Ulimanopano/Robot-6GDL/Robot_6GDL_V11/04_Documentacion/Cinematica_directa_V11_apuntes.pdf

Título: | Cinemática directa — | Robot | 6GDL V9
Tabla DH (Craig / | modificada) y robot

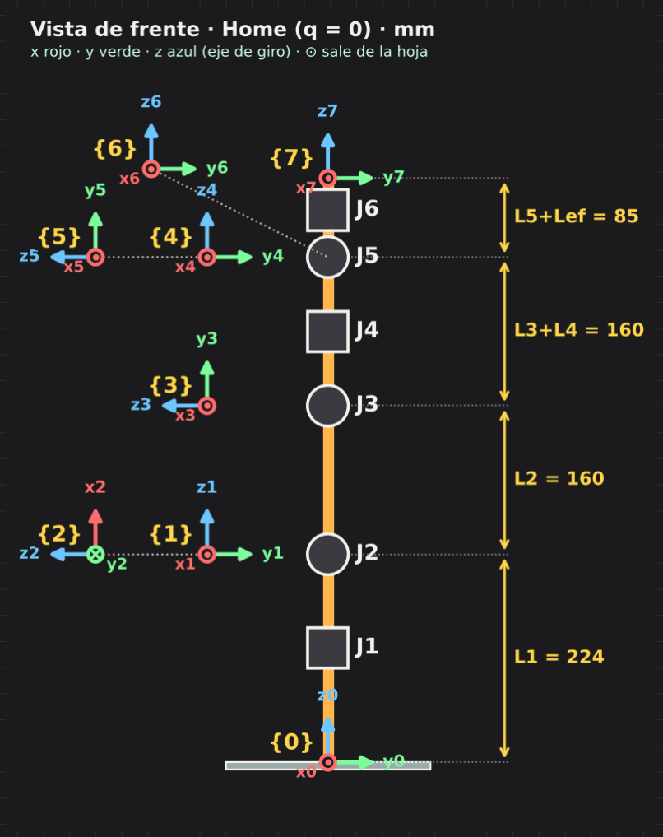
[picture p1: figure]

xi−1 ∶ | zi−1→ zi

zi

∶ | xi−1→ xi
i | αi−1 | ai−1 | di

θi

1 | 0 | 0 | L1

θ1
2 | π/2 | 0 | 0 | θ2 | + π/2
3 | 0 | L2 | 0 | θ3 | − π/2
4 | −π/2 | 0 | L3 | + L4

θ4
5 | π/2 | 0 | 0 | θ5
6 | −π/2 | 0 | 0 | θ6
7 | 0 | 0 | L5 | + Lef | 0

q = [θ1

, θ2

, θ3

, θ4

, θ5

, θ6

]

T

Notación
ci = cos θi
, | si = sin θi
c23 | = cos(θ2 | + θ3

)
s23 | = sin(θ2 | + θ3

)
Lw = L3 + L4
(hasta la muñeca)

Medidas (mm)
L1 | = 224, | L2 | = 160
Lw | = 160, | L5 | + Lef = 85

Muñeca esférica
Los ejes de J4, J5 y J6 se cruzan en el punto
W, por | eso | 4
5T y

5
6T no tienen traslación.

Matriz | de | una fila

i−1
iT = Rx

(αi−1) Dx

(ai−1) Rz

(θi

) Dz

(di

) =

⎡
⎢
⎢
⎣
cθi | −sθi | 0 | ai−1
sθi
cαi−1 | cθi
cαi−1 | −sαi−1 | −sαi−1 di
sθi
sαi−1 | cθi
sαi−1 | cαi−1 | cαi−1 di
0 | 0 | 0 | 1

⎤
⎥
⎥
⎦
Ojo | con los offsets | (identidades)
Fila | 2: | cos(θ2 +

π
2

) = −s2

, sin(θ2 +

π
2

) = c2
Fila | 3: | cos(θ3 −

π
2

) = s3

| , | sin(θ3 −

π
2

) = −c3
Con | α = ±π/2: cos α = 0 y | sin α = ±1, | por | eso aparecen | los 0 | y | ±1 en las columnas 2 y 3.
1. Matrices | de | cada | fila

0
1T =

⎡
⎢
⎢
⎣
c1 | −s1 0 | 0
s1
c1 | 0 | 0
0 | 0 | 1 | L1
0 | 0 | 0 | 1

⎤
⎥
⎥
⎦

1
2T =

⎡
⎢
⎢
⎣
−s2 | −c2 | 0 | 0
0 | 0 | −1 0
c2 | −s2 | 0 | 0
0 | 0 | 0 | 1

⎤
⎥
⎥
⎦

2
3T =

⎡
⎢
⎢
⎣

s3

c3 0 L2
−c3
s3 0 | 0
0 | 0 | 1 | 0
0 | 0 | 0 | 1

⎤
⎥
⎥
⎦

3
4T =

⎡
⎢
⎢
⎣
c4 | −s4 0 | 0
0 | 0 | 1 | Lw
−s4 | −c4 0 | 0
0 | 0 | 0 | 1

⎤
⎥
⎥
⎦

4
5T =

⎡
⎢
⎢
⎣
c5 | −s5 | 0 | 0
0 | 0 | −1 0
s5
c5 | 0 | 0
0 | 0 | 0 | 1

⎤
⎥
⎥
⎦

5
6T =

⎡
⎢
⎢
⎣
c6 | −s6 | 0 | 0
0 | 0 | 1 | 0
−s6 | −c6 | 0 | 0
0 | 0 | 0 | 1

⎤
⎥
⎥
⎦

6
7T =

⎡
⎢
⎢
⎣
1 | 0 | 0 | | 0
0 | 1 | 0 | | 0
0 | 0 | 1 | (L5 | + Lef )
0 | 0 | 0 | | 1

⎤
⎥
⎥
⎦

2. Multiplicación | paso a paso
Se | va multiplicando | por la derecha: | cada nueva fila | se | pega a lo que ya | se | tenía.

0

2T = 0
1T

1
2T =

⎡
⎢
⎢
⎣
c1 | −s1 0 | 0
s1
c1 | 0 | 0
0 | 0 | 1 | L1
0 | 0 | 0 | 1

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
−s2 | −c2 | 0 | 0
0 | 0 | −1 | 0
c2 | −s2 | 0 | 0
0 | 0 | 0 | 1

⎤
⎥
⎥
⎦

0
2T =

⎡
⎢
⎢
⎣

−c1

s2 | −c1 c2 | s1 | 0
−s1
s2 | −c2
| s1 | −c1 | 0
c2 | −s2 | 0 | L1
0 | 0 | 0 | 1

⎤
⎥
⎥
⎦

0

3T = 0
2T

2
3T =

⎡
⎢
⎢
⎣

−c1

s2 −c1

c2

s1 0
−s1
s2 | −c2
s1 | −c1 | 0
c2 | −s2 | 0 | L1
0 | 0 | 0 | 1

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
c3 0 L2
−c3
s3 0 | 0
0 | 0 | 1 | 0
0 | 0 | 0 | 1

⎤
⎥
⎥
⎦

0
3T =

⎡
⎢
⎢
⎣

c1

c23 | −c1
s23 | s1 | −L2
| | | | c1 s2
c23s1 | −s1
s23 | −c1 | −L2
| | | | s1 s2
s23 | c23 | 0 | L1 | + L2

c2
0 | 0 | 0 | | 1

⎤
⎥
⎥
⎦
Aquí aparece | c23: | c2
c3 − s2
s3 = cos(θ2 | + θ3
) y | s2 c3 + c2
s3 = sin(θ2 | + θ3
) | (J2 y J3 son paralelos).

0

4T = 0
3T

3
4T =

⎡
⎢
⎢
⎣

c1

c23 | −c1
s23 | s1 | −L2

c1

s2
c23s1 | −s1
s23 | −c1 | −L2

s1

s2
s23 | c23 | 0 | L1 + L2

c2
0 | 0 | 0 | 1

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
c4 | −s4 | 0 | 0
0 | 0 | 1 | Lw
−s4 | −c4 | 0 | 0
0 | 0 | 0 | 1

⎤
⎥
⎥
⎦

0
4T =

⎡
⎢
⎢
⎣

c1

c23c4 − s1

s4 | −c1
c23s4 | − c4
s1 | −c1
s23 | −L2

c1

s2 − Lwc1

s23
c1

s4 + c23c4

s1

c1

c4 − c23s1

s4 | −s1
s23 | −L2

s1

s2 − Lws1

s23
c4
s23 | −s23s4
c23 | L1 | + L2
| | | c2 + Lwc23
0 | 0 | 0 | 1

⎤
⎥
⎥
⎦

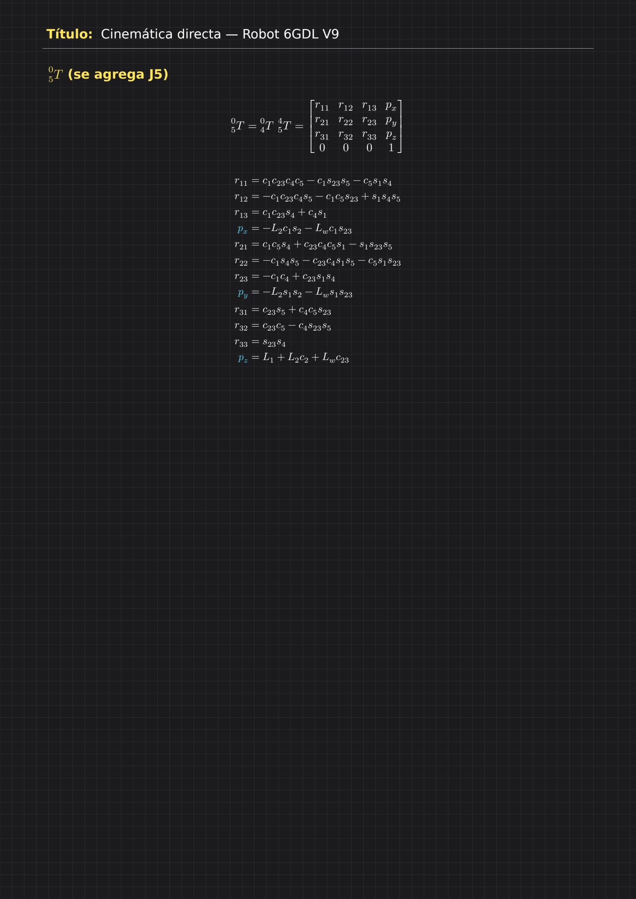
[picture p2: figure]
5T (se agrega J5); − Lwc1; − Lws1; c2 + Lwc23

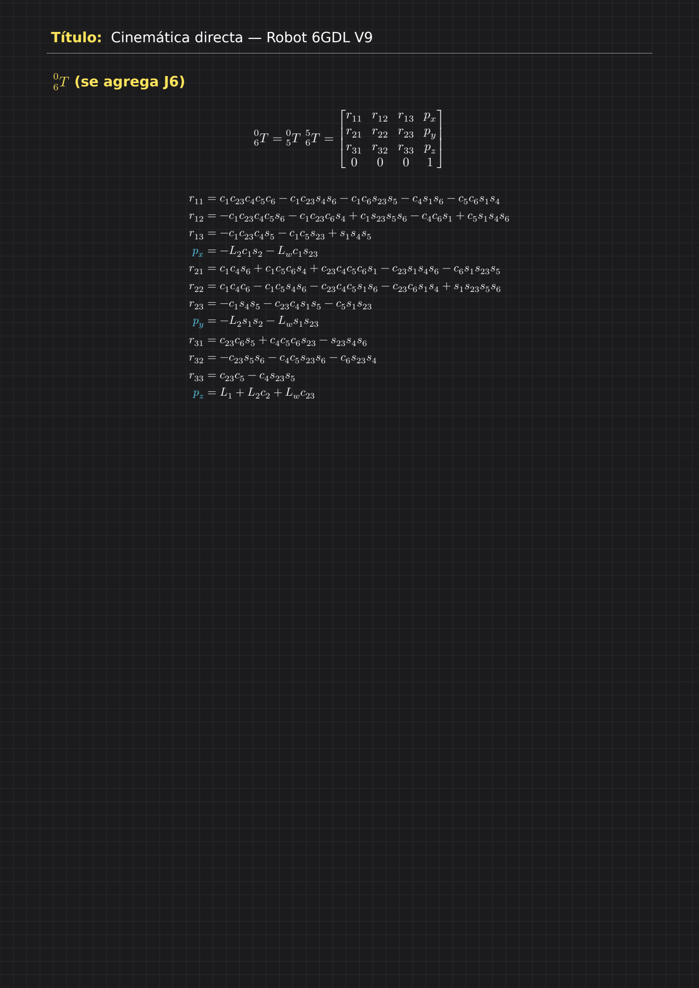
[picture p3: figure]
6T (se agrega J6); − Lwc1; − Lws1; c2 + Lwc23

7T — | base | {0} → | punta | {7}

0

7T = 0
6T

6
7T =

⎡
⎢
⎢
⎣
r11 | r12 r13 | px
r21 | r22 r23 | py
r31 | r32 r33 | pz
0 | 0 | 0 | 1

⎤
⎥
⎥
⎦
| | | | r11 | = c1

c23c4

| | | | | | c5

c6 − c1

| | | | | | | | | c23s4
s6 | − c1
| | | | | | | | | | c6

s23s5 − c4

| | | | | | | | | | | | | s1
| | | | | | | | | | | | | s6 | − c5 c6

s1

| | | | | | | | | | | | | | | s4
| | | | r12 | = −c1

c23c4

| | | | | | | c5
s6 | − c1

c23c6

| | | | | | | | | | s4 + c1

s23s5

s6 | − c4
| | | | | | | | | | | | | c6 | s1 + c5

s1

| | | | | | | | | | | | | | | s4

s6
| | | | r13 | = −c1

c23c4

s5 | − c1
| | | | | | | | | c5
| | | | | | | | | s23 | + s1 s4 s5
| | | | px | = −L2 | c1

s2 + (L5 + Lef ) (−c1

| | | | | | | | | | c23c4
s5 | − c1

c5

| | | | | | | | | | | | | s23 | + s1 s4

s5

) − Lwc1

| | | | | | | | | | | | | | | | s23
| | | | r21 | = c1 c4

s6 + c1

| | | | | | | c5 | c6

s4 + c23c4

| | | | | | | | | | c5 c6
s1 | − c23s1

s4

s6 − c6

| | | | | | | | | | | | | | s1

s23s5
| | | | r22 | = c1 c4

c6 − c1

| | | | | | | c5 | s4

s6 − c23c4

| | | | | | | | | | c5 s1
s6 | − c23c6

s1

s4 + s1

s23s5

| | | | | | | | | | | | | | | s6
| | | | r23 | = −c1

s4

s5 | − c23c4
| | | | | | | | | s1

s5 − c5

| | | | | | | | | | s1 s23
| | | | py | = −L2 | s1

s2 + (L5 + Lef ) (−c1

| | | | | | | | | | s4
s5 | − c23c4

s1

s5 − c5

| | | | | | | | | | | | | | s1

s23) − Lws1

| | | | | | | | | | | | | | | | s23
| | | | r31 | = c23c6

s5 + c4

c5

| | | | | | | | c6

s23 − s23s4

| | | | | | | | | | s6
r32 | = −c23s5

s6 − c4

| | | | | | | | c5 | s23s6 | − c6 s23s4
r33 | = c23c5 | − c4

s23s5
pz | = L1 | + L2
c2 | + (L5 + Lef ) (c23c5 − c4

s23s5

) + Lwc23

Comprobación | en Home (q = 0)
Con | ci | = 1, | si | = 0, | c23 = | 1, | s23 | = | 0: | px = 0, | py | = | 0, | pz = | L1 | + L2 + Lw + (L5 | + Lef ) =
224 + 160 + 160 + 85 = 629 mm | ✓
Coincide | con | SolidWorks, | Simulink, MATLAB y | el | programa del profe.
