Ulimanopano/Robot-6GDL/Robot_6GDL_v4/Documentos/Analisis_Cinematico_Robot_6GDL.pdf

# Análisis cinemático

### Robot de 6 GDL con muñeca esférica

Denavit–Hartenberg modificado · Cinemática directa e inversa

## Nava Nolazco Nantai

# Datos del problema

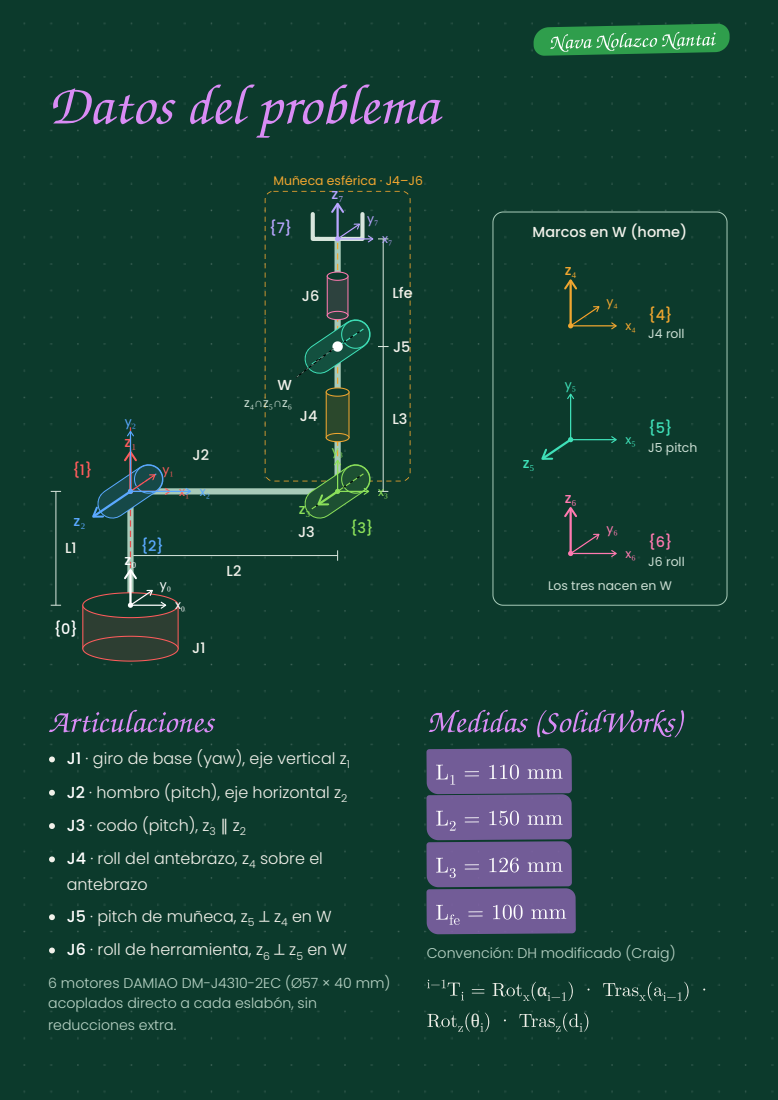
[picture p4: page 2]

Los tres nacen en W

Articulaciones
J1 · giro de base (yaw), eje vertical z1
J2 · hombro (pitch), eje horizontal z2
J3 · codo (pitch), z3 ∥ z2
J4 · roll del antebrazo, z4 sobre el
antebrazo
J5 · pitch de muñeca, z5 ⟂ z4 en W
J6 · roll de herramienta, z6 ⟂ z5 en W
6 motores DAMIAO DM-J4310-2EC (Ø57 × 40 mm)
acoplados directo a cada eslabón, sin
reducciones extra.

Convención: DH modificado (Craig)

i−1Ti = Rotx(αi−1) · Trasx(ai−1) ·
Rotz(θi) · Trasz(di)

# Marcos y tabla DH

# Cómo se colocan los marcos

zi va siempre sobre el eje de giro de la articulación i (el z sigue al eje).

### xi sobre la normal común entre zi y zi+1

, apuntando al siguiente eslabón.

### {0} en la base del cilindro de J1; {1} y {2} nacen en el hombro (esquina); {3} en el

codo.

### {4}, {5} y {6} nacen los tres en el centro de muñeca W; {7} en la punta de la

herramienta.
Home óptimo: todos los θi = 0 → brazo en “L” (L2 horizontal, L3 vertical), codo a 90°.

# Tabla de Denavit–Hartenberg

i | i−1 | zi−1 | xi−1 | αi−1 | ai−1 | di | θi
1 | 0 | z0 | x0 | 0 | 0 | L1 | q1
2 | 1 | z1 | x1 | +90° | 0 | 0 | q2
3 | 2 | z2 | x2 | 0 | L2 | 0 | q3
4 | 3 | z3 | x3 | −90° | 0 | L3 | q4
5 | 4 | z4 | x4 | +90° | 0 | 0 | q5
6 | 5 | z5 | x5 | −90° | 0 | 0 | q6
7 | 6 | z6 | x6 | 0 | 0 | Lfe | 0

αi−1

: giro de zi−1 a zi alrededor de xi−1

- ai−1

: distancia sobre xi−1

- di

: distancia sobre zi

- θi
| | | | | | | : giro alrededor
| | | | de zi

# Regla de Pieper (muñeca esférica)

### Los últimos tres ejes se cortan en un punto si las distancias entre ellos son cero:

a4 = a5 = 0 y d5 = d6 = 0 ⇒ O4 = O5 = O6 = W

✓ Cumple: z4 ∩ z5 ∩ z6 = W

# Matrices de transformación

### Sustituyendo cada renglón de la tabla en la matriz general del DH modificado:

i−1Ti =

cθi | −sθi | 0 | ai−1

sθicαi−1 cθicαi−1 −sαi−1 −sαi−1di

sθisαi−1 cθisαi−1 | cαi−1 | cαi−1di
0 | 0 | 0 | 1
Notación: ci = cos qi

, si = sin qi

, c23 = cos(q2+q3), s23 = sin(q2+q3)

0T1 =

c1 | −s1 | 0 | 0
s1 | c1 | 0 | 0
0 | 0 | 1 L1
0 | 0 | 0 | 1

1T2 =

c2 | −s2 | 0 | 0
0 | 0 | −1 0
s2 | c2 | 0 | 0
0 | 0 | 0 | 1

2T3 =

c3 | −s3 | 0 L2
s3 | c3 | 0 | 0
0 | 0 | 1 | 0
0 | 0 | 0 | 1

3T4 =

c4 | −s4 | 0 | 0
0 | 0 | 1 L3
−s4 | −c4 | 0 | 0
0 | 0 | 0 | 1

4T5 =

c5 | −s5 | 0 | 0
0 | 0 | −1 0
s5 | c5 | 0 | 0
0 | 0 | 0 | 1

5T6 =

c6 | −s6 | 0 0
0 | 0 | 1 0
−s6 | −c6 | 0 0
0 | 0 | 0 1

6T7 =

1 0 0 | 0
0 1 0 | 0

0 0 1 Lfe

0 0 0 1

0T7 =

0T1 ·

1T2 ·

2T3 ·

3T4 ·

4T5 ·

5T6 ·

6T7

# Brazo (q₁ – q₃)

# Multiplicamos las del brazo

0T2 =

0T1·

1T2 =

c1c2 | −c1s2 | s1 | 0
s1c2 | −s1s2 | −c1 | 0
s2 | c2 | 0 | L1
0 | 0 | 0 | 1

0T3 =

0T2·

2T3 =

c1c23 | −c1s23 | s1 | L2c1c2
s1c23 | −s1s23 | −c1 | L2s1c2
s23 | c23 | 0 | L1 + L2s2
0 | 0 | 0 | 1

Se usa c2c3 − s2s3 = c23 y s2c3 + c2s3 = s23

# Centro de muñeca W

### El origen de {4} visto desde {3} es

3PW = (0, L3

### , 0), entonces:

0PW = 0T3 · [0 L3 0 1]

T

### W solo depende de q1

, q2

, q3

### : la muñeca no mueve su centro → desacople posición /

orientación.

# Ejes del marco {4} (columnas de

0R4
)

x4 = ( c1c23c4 − s1s4
, s1c23c4 + c1s4

, s23c4 )

y4 = ( −c1c23s4 − s1c4
, −s1c23s4 + c1c4
| | | , −s23s4 )

z4 = ( −c1s23
, −s1s23

, c23 )

W = ( c1

(L2c2 − L3s23

) , s1

(L2c2 − L3s23

) , L1 + L2s2 + L3c23

)

# Muñeca esférica (q₄ – q₆)

# Multiplicamos las de la muñeca

4T7 =

4T5·

5T6·

6T7 =

c5c6 | −c5s6 | −s5 | −Lfes5
s6 | c6 | 0 | 0
s5c6 | −s5s6 | c5 | Lfec5
0 | 0 | 0 | 1

### La posición de la herramienta desde W es Lfe·(−s5

### , 0, c5): es justo Lfe sobre el eje a

(z7). Los marcos {4}, {5}, {6} no tienen traslación entre sí → los tres ejes pasan por W.

# Los tres ejes en W

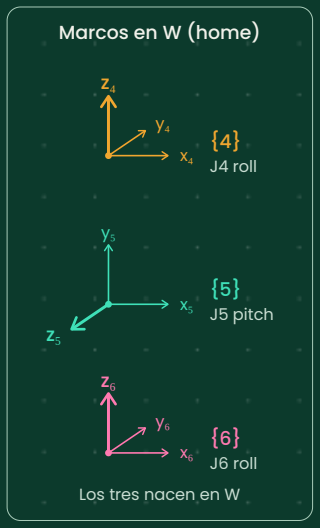
[picture p5: figure]
Marcos en W (home); {4} J4 roll; {5} J5 pitch; {6} J6 roll Los tres nacen en W

### En home los marcos {4}, {5} y {6} comparten origen: z4 vertical → roll del antebrazo (J4) z5 horizontal → pitch de muñeca (J5) z6 vertical → roll de herramienta (J6) Como z5 ⟂ z4 y z6 ⟂ z5 y los tres pasan por W, la orientación se

resuelve sin mover W: eso es lo que pide la regla del profe.

# Rotación de la muñeca vista desde {3}

3R7 = 3R4 · 4R7

3R7 =

c4c5c6 − s4s6 | −c4c5s6 − s4c6 −c4s5
s5c6 | −s5s6 | c5
−s4c5c6 − c4s6 | s4c5s6 − c4c6 | s4s5

### Esta matriz es la que se compara en la inversa para sacar q4

, q5

, q6

:

W = O4 = O5 = O6

m23 = c5 | m13 = −c4s5 | m33 = s4s5 | m21 = s5c6 | m22 = −s5s6

# Cinemática directa

0T7 =

0T4 ·

4T7 =

n o a p

0 0 0 1

n = c5c6·x4 + s6·y4 + s5c6·z4

o = −c5s6·x4 + c6·y4 − s5s6·z4

a = −s5·x4 + c5·z4

# Comprobación en home (q = 0)

x4 = (1,0,0), y4 = (0,1,0), z4 = (0,0,1), W = (L2

, 0, L1+L3)

0T7home =

1 0 0 | L2
0 1 0 | 0

0 0 1 L1 + L3 + Lfe

0 0 0 | 1

### — coincide con Marco_7 en SolidWorks

# Ejemplo numérico

q = (30°, 25°, −50°, 40°, 60°, −20°) · c23 = cos(−25°) = 0.9063, s23 =

−0.4226

L2c2 − L3s23 = 150(0.9063) − 126(−0.4226) = 189.20

0T7 =

0.7329 −0.6777 −0.0594 157.91

0.4693 | 0.5668 | −0.6771 | 26.89
0.4925 | 0.4684 | 0.7335 | 360.94
0 | 0 | 0 | 1

p = W + Lfe·a

phome = (150, 0, 336) mm

W = (163.85, 94.60, 287.59) mm

p = (157.91, 26.89, 360.94) mm

# Cinemática inversa

### Dato:

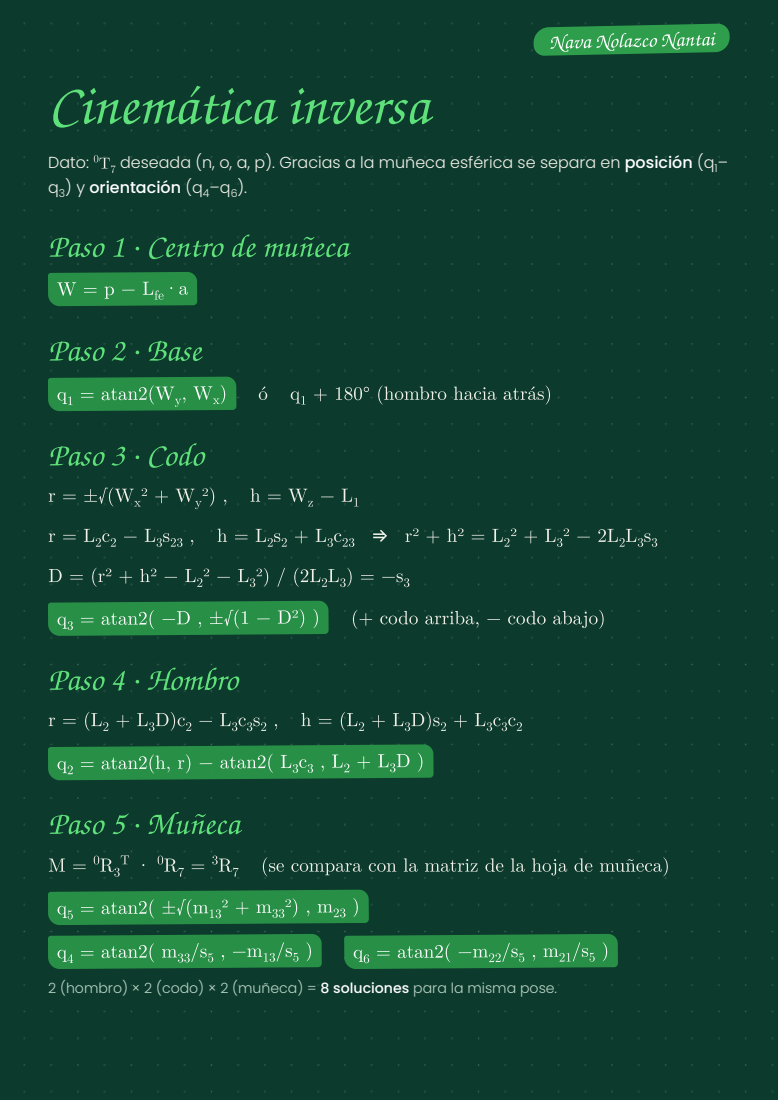
[picture p6: page 8]
Paso 2 · Base; q1 + 180° (hombro hacia atrás); Paso 3 · Codo; Paso 4 · Hombro; Paso 5 · Muñeca; (se compara con la matriz de la hoja de muñeca); W = p − Lfe·a; q1 = atan2(Wy; q3 = atan2( −D , ±√(1 − D²) ); q2 = atan2(h, r) − atan2( L3c3; q5 = atan2( ±√(m13 ² + m33; q6 = atan2( −m22/s5

0T7 deseada (n, o, a, p). Gracias a la muñeca esférica se separa en posición (q1–
q3) y orientación (q4–q6

Paso 1 · Centro de muñeca

(+ codo arriba, − codo abajo)

q4 = atan2( m33/s5
2 (hombro) × 2 (codo) × 2 (muñeca) = 8 soluciones para la misma pose.

# Ejemplo de inversa

### Partimos de la

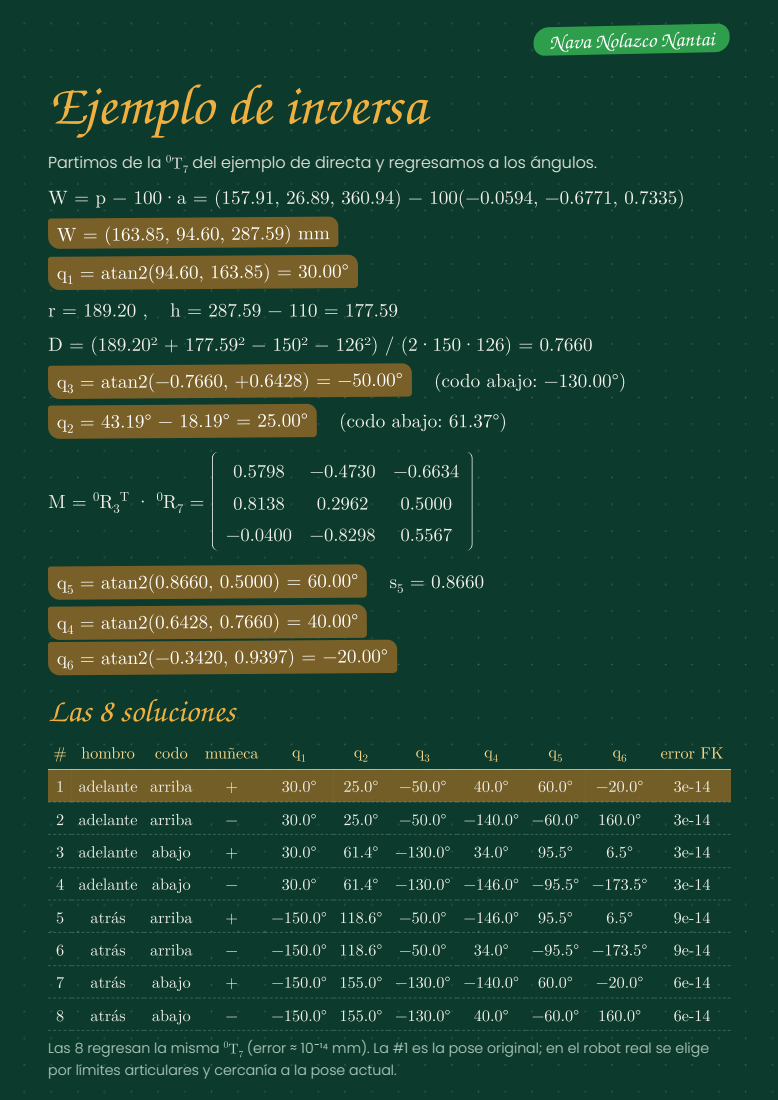
[picture p7: page 9]
(codo abajo: −130.00°); (codo abajo: 61.37°); Las 8 soluciones; # hombro; codo muñeca; error FK; adelante; arriba; 2 adelante arriba; 3 adelante abajo; 4 adelante abajo; atrás; abajo; q1 = atan2(94.60, 163.85) = 30.00°; q3 = atan2(−0.7660, +0.6428) = −50.00°; q5 = atan2(0.8660, 0.5000) = 60.00°; q4 = atan2(0.6428, 0.7660) = 40.00°; q6 = atan2(−0.3420, 0.9397) = −20.00°

0T7 del ejemplo de directa y regresamos a los ángulos.

Las 8 regresan la misma
por límites articulares y cercanía a la pose actual.

(error ≈ 10⁻¹⁴ mm). La #1 es la pose original; en el robot real se elige

# Singularidades

### Muñeca · s5 = 0 (q5 = 0° ó 180°): z4 y z6 quedan alineados, solo se conoce q4 ± q6

. El
home cae aquí → para trabajar conviene q5 ≠ 0.
Codo · D = ±1 (q3 = ∓90°): L2 y L3 alineados, brazo totalmente estirado o doblado. Hombro · W sobre z0 (Wx = Wy = 0, es decir L2c2 = L3s23): q1 queda libre.

Alcance de W desde el hombro: |L2 − L3

| = 24 mm ≤ ‖W − O2‖ ≤ L2 + L3 =

276 mm

# Resultados

DH modificado · 7 marcos

a4 = a5 = d5 = d6 = 0

z4 ∩ z5 ∩ z6 = W

L = 110 / 150 / 126 / 100 mm

# Pieper

W(q1
,q2

,q3)

p = W + Lfe·a

phome = (150, 0, 336)

8 soluciones de IK

Cinem.

} | }

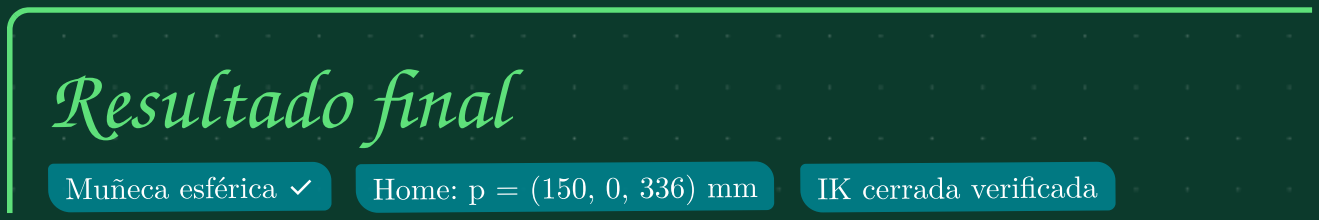
[picture p8: figure]
Resultado final

Muñeca esférica ✓ | Home: p = (150, 0, 336) mm | IK cerrada verificada
