Ulimanopano/Robot-6GDL/Robot_6GDL_V11/04_Documentacion/Torque_motores/Torque_GIM3505-36_J1_J4_J5_J6.jpg

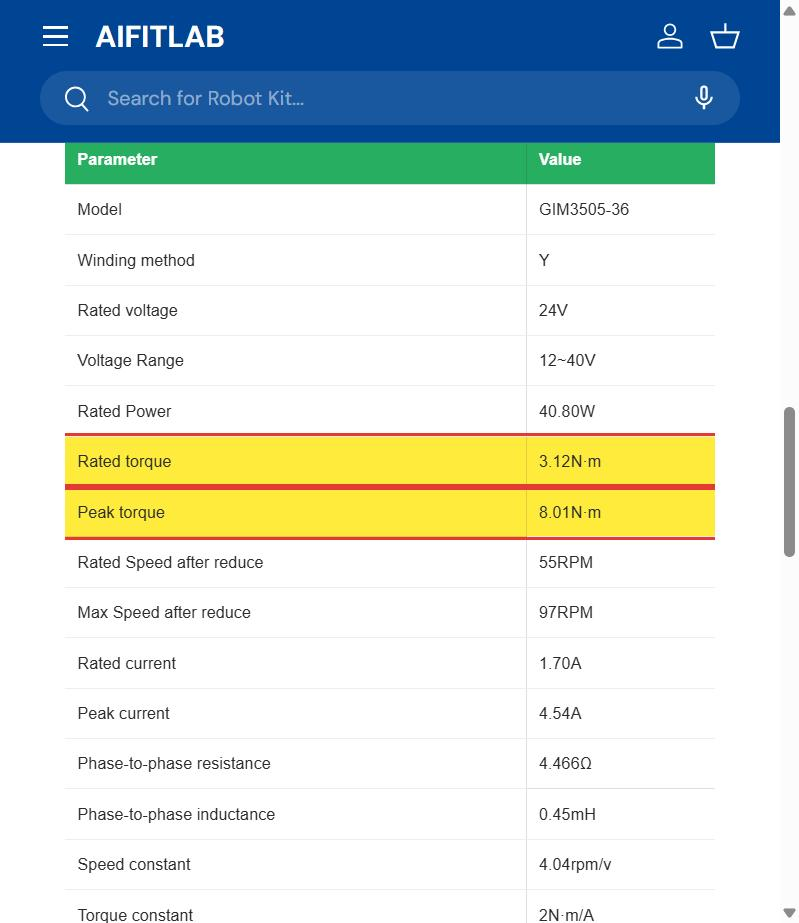
Robot_6GDL_V11/04_Documentacion/Torque_motores/Torque_GIM3505-36_J1_J4_J5_J6.jpg
