Ulimanopano/Robot-6GDL/Robot_6GDL_V11/04_Documentacion/Torque_motores/Torque_GIM3510-64_GDZ34_J3.jpg

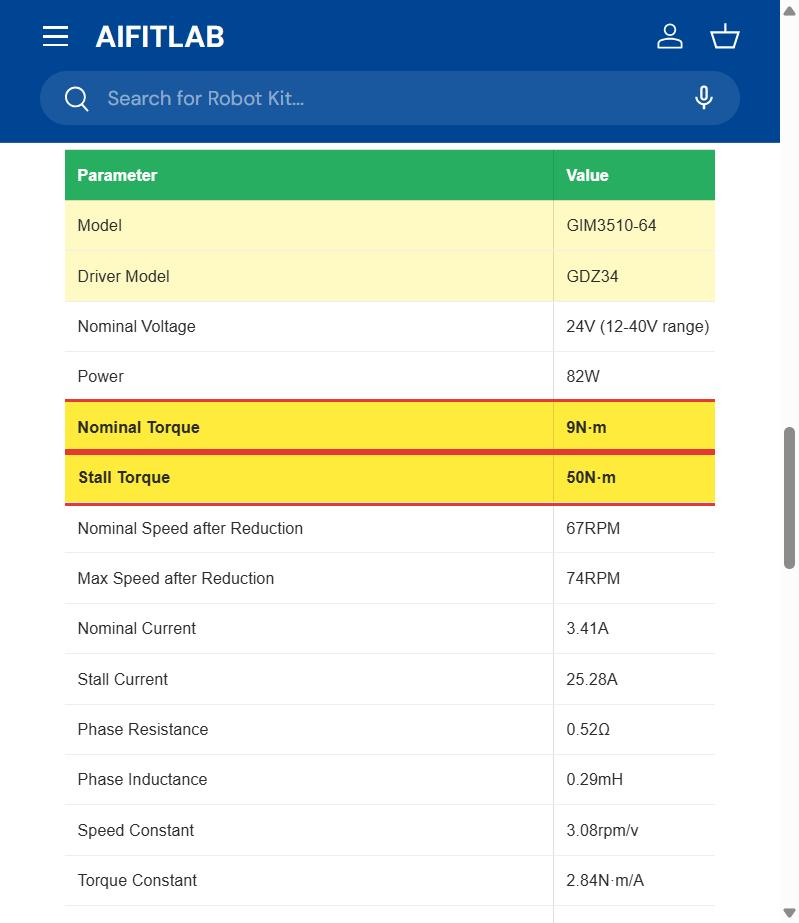
Robot_6GDL_V11/04_Documentacion/Torque_motores/Torque_GIM3510-64_GDZ34_J3.jpg
