Ulimanopano/Robot-6GDL/Robot_6GDL_V11/04_Documentacion/Torque_motores/Torque_GIM6010-48_GDZ468H_J2.jpg

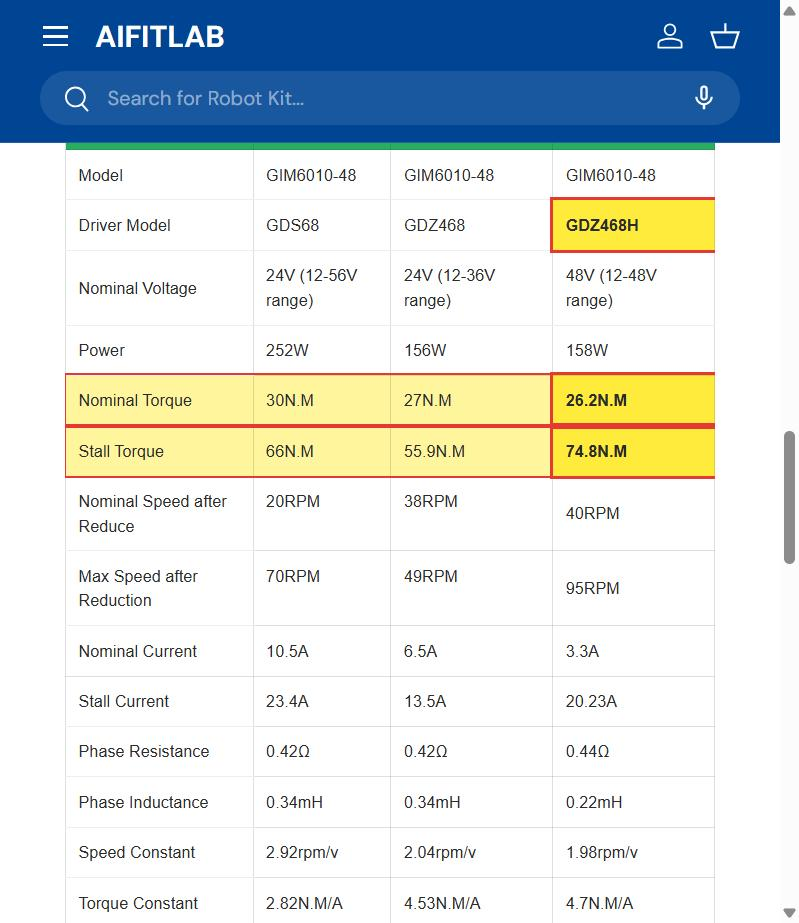
Robot_6GDL_V11/04_Documentacion/Torque_motores/Torque_GIM6010-48_GDZ468H_J2.jpg
