Ulimanopano/Robot-6GDL/Robot_6GDL_V11/02_Piezas/10_Motores/GIM3510-64.SLDPRT

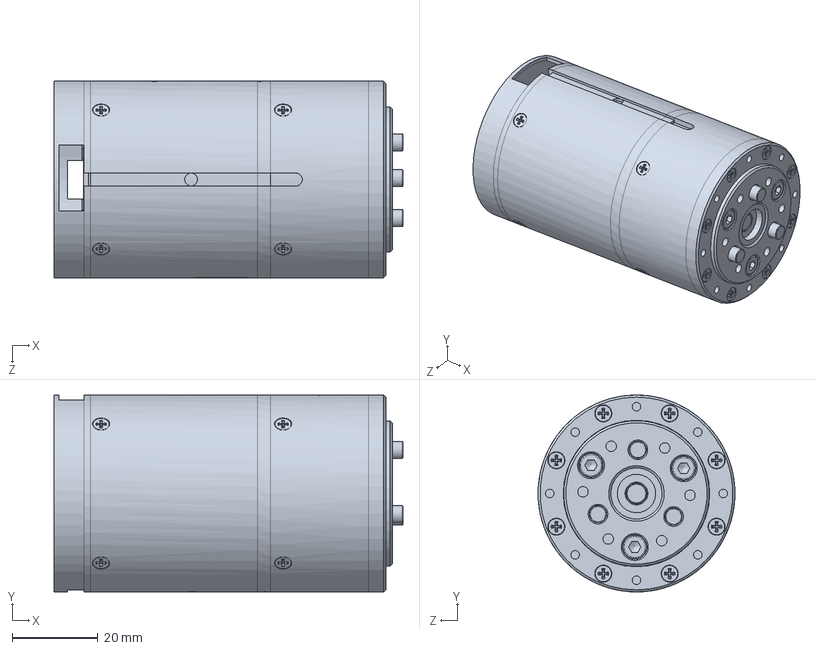
[picture p12: CAD file, 2026-11-11]
Robot_6GDL_V11/02_Piezas/10_Motores/GIM3510-64.SLDPRT
81.5 x 46.0 x 46.0 mm
