Ulimanopano/Robot-6GDL/Robot_6GDL_V11/02_Piezas/11_Baleros/R-04_Balero_axial_NSK_51110.SLDPRT

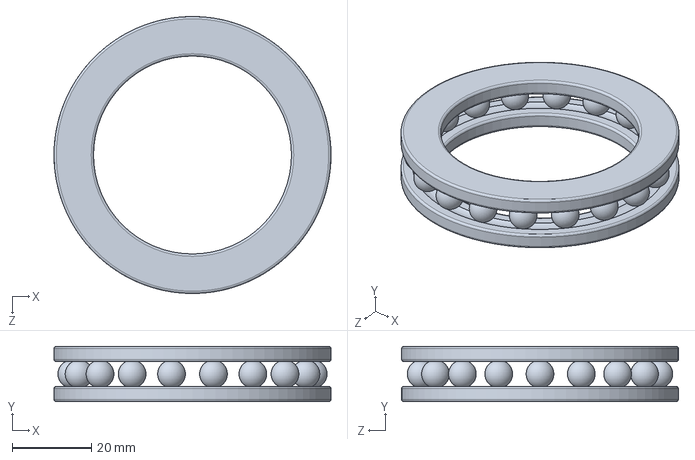
[picture p13: CAD file, 2026-11-11]
Robot_6GDL_V11/02_Piezas/11_Baleros/R-04_Balero_axial_NSK_51110.SLDPRT
70.0 x 14.0 x 70.0 mm
