Ulimanopano/Robot-6GDL/Robot_6GDL_V11/02_Piezas/14_Electronica/E-03_Raspberry_Pi_5.SLDPRT

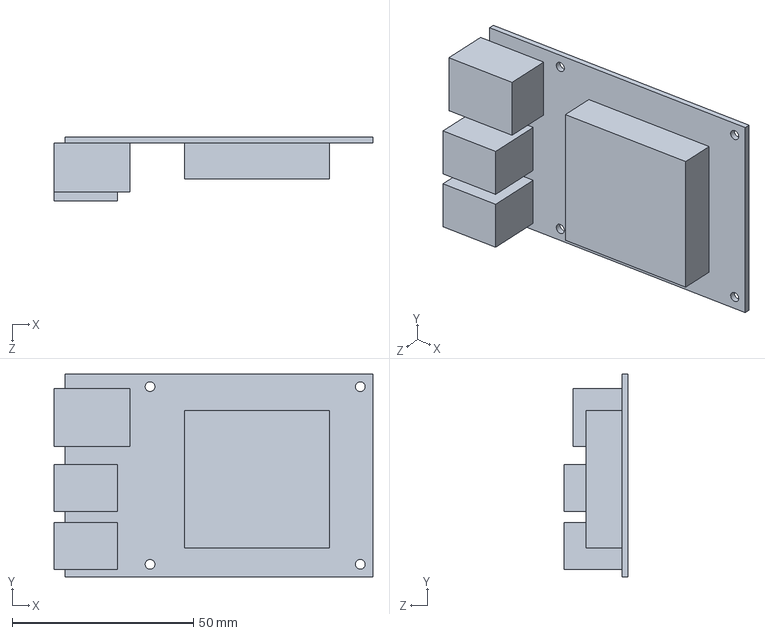
[picture p14: CAD file, 2026-11-11]
Robot_6GDL_V11/02_Piezas/14_Electronica/E-03_Raspberry_Pi_5.SLDPRT
88.0 x 56.0 x 17.6 mm
