Ulimanopano/Robot-6GDL/Robot_6GDL_V11/02_Piezas/B06_Pared_caja_puertos.SLDPRT

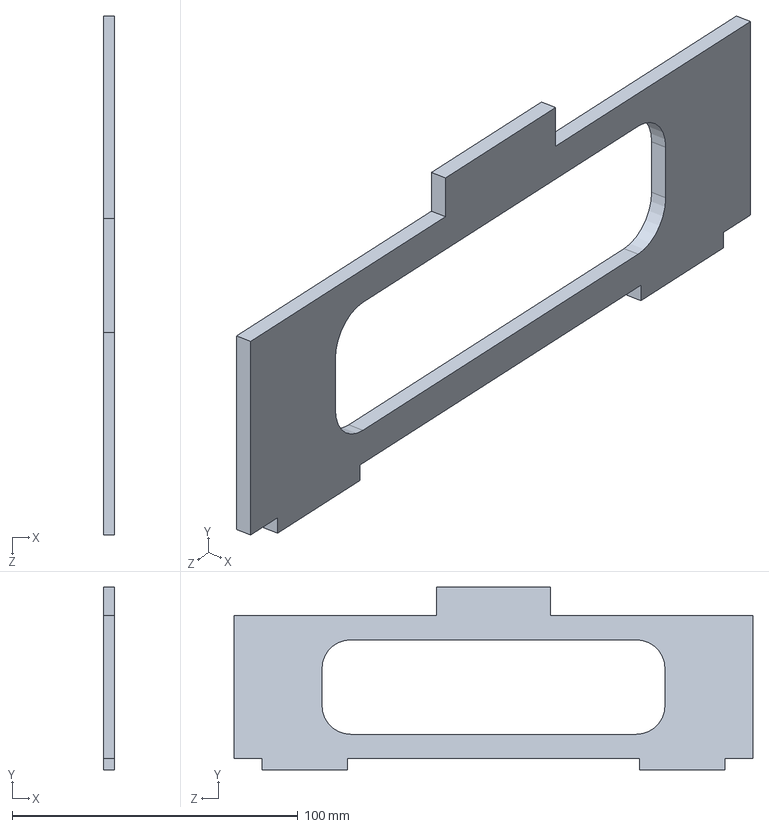
[picture p15: CAD file, 2026-11-11]
Robot_6GDL_V11/02_Piezas/B06_Pared_caja_puertos.SLDPRT
4.00 x 64.0 x 181.6 mm
