Ulimanopano/Robot-6GDL/Robot_6GDL_V11/02_Piezas/10_Motores/GIM6010-48.SLDPRT

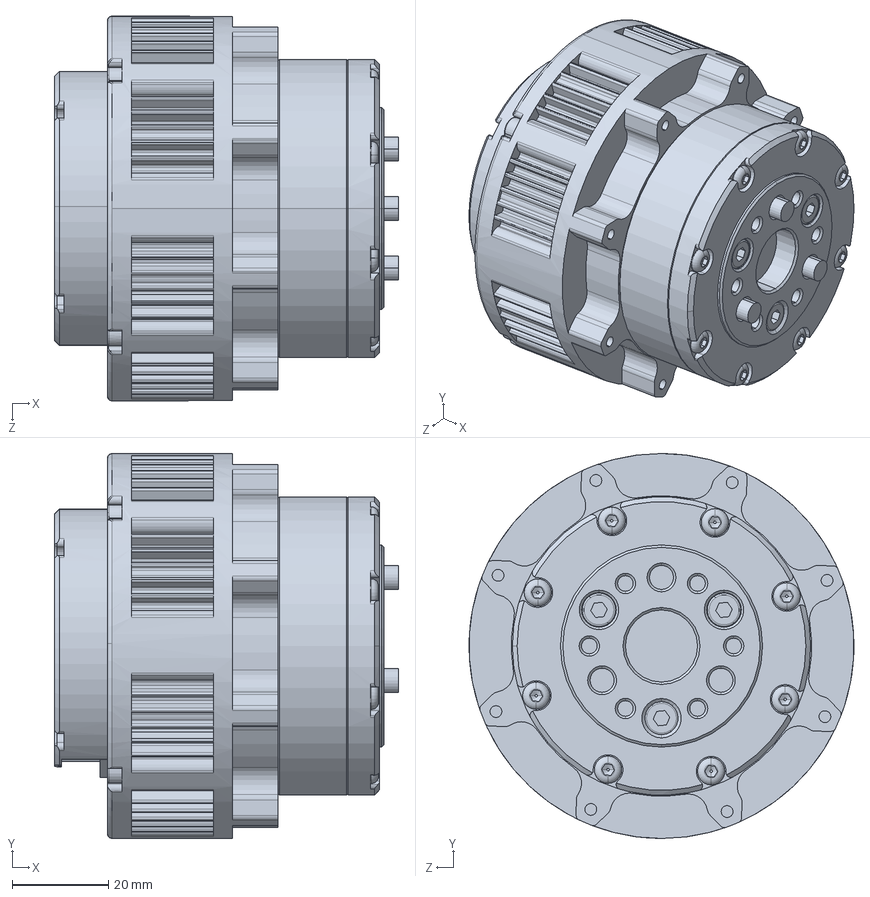
[picture p17: CAD file, 2026-11-11]
Robot_6GDL_V11/02_Piezas/10_Motores/GIM6010-48.SLDPRT
71.5 x 80.0 x 80.0 mm
