Ulimanopano/Robot-6GDL/Robot_6GDL_V11/02_Piezas/11_Baleros/balero 696zz.SLDPRT

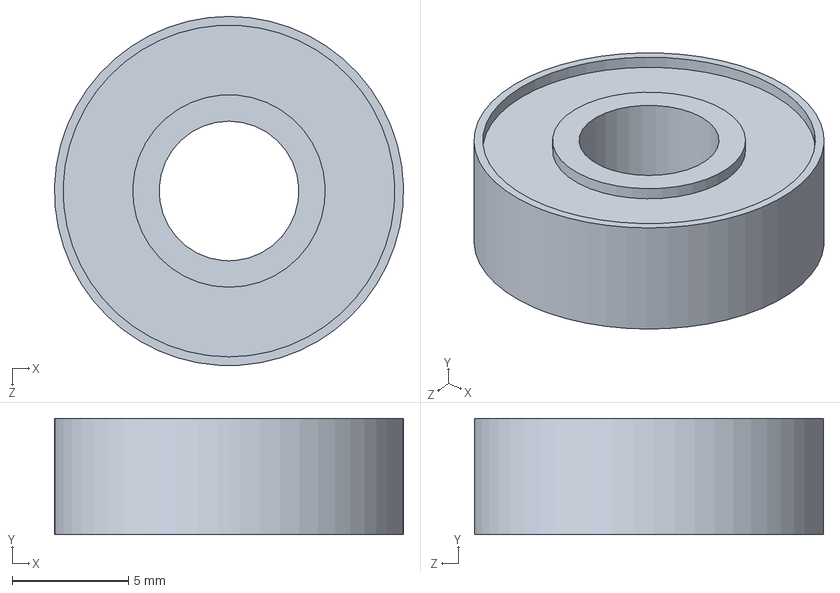
[picture p18: CAD file, 2026-11-11]
Robot_6GDL_V11/02_Piezas/11_Baleros/balero 696zz.SLDPRT
15.0 x 5.00 x 15.0 mm
