Ulimanopano/Robot-6GDL/Robot_6GDL_V11/02_Piezas/14_Electronica/E-02_Base_cincho_M3_15x15.SLDPRT

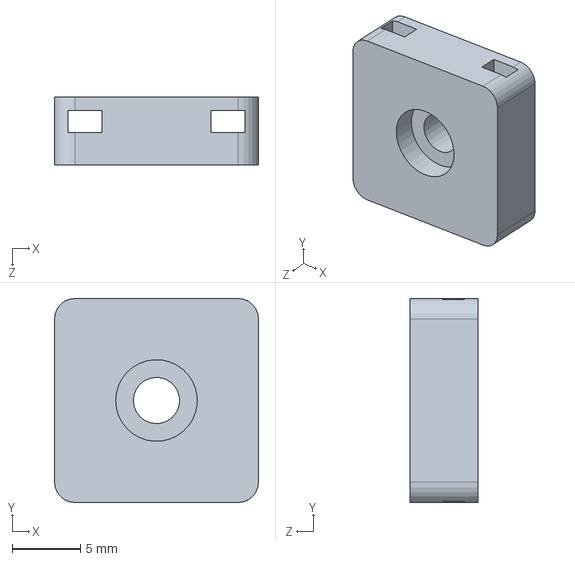
[picture p19: CAD file, 2026-11-11]
Robot_6GDL_V11/02_Piezas/14_Electronica/E-02_Base_cincho_M3_15x15.SLDPRT
15.0 x 15.0 x 5.00 mm
