Ulimanopano/Robot-6GDL/Robot_6GDL_V11/02_Piezas/L5-03_Repisa_motor_J6.SLDPRT

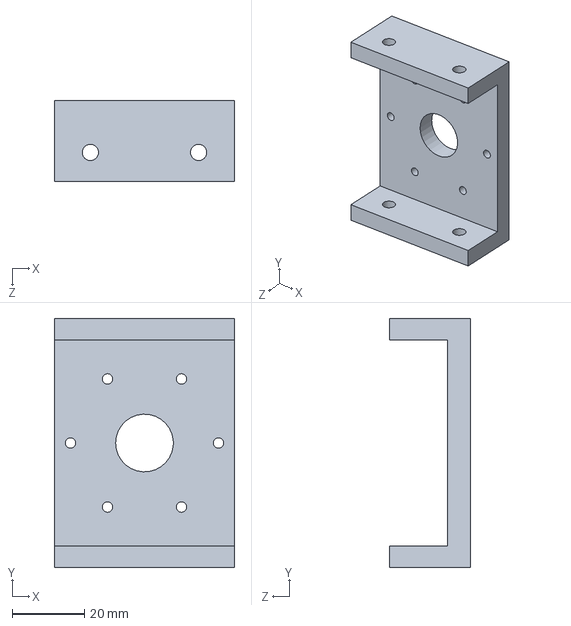
[picture p20: CAD file, 2026-11-11]
Robot_6GDL_V11/02_Piezas/L5-03_Repisa_motor_J6.SLDPRT
50.0 x 69.0 x 22.4 mm
