Ulimanopano/Robot-6GDL/Robot_6GDL_V11/05_Matlab/V11_link_2.step

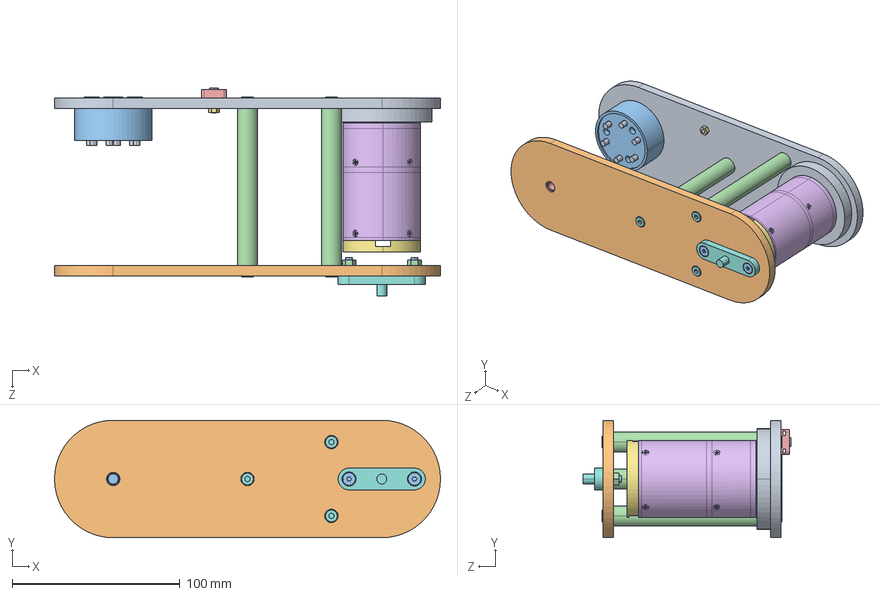
[picture p21: CAD file, 2026-11-11]
Robot_6GDL_V11/05_Matlab/V11_link_2.step
230.0 x 70.0 x 124.2 mm
L2-01_Placa_brazo_motor_J3
L2-02_Placa_brazo_balero_J2
L2-03_Cubo_J2
L2-04_Separador_D12 x 3
balero 696zz
GIM3510-64
EF-J3_Ejefalso
ISO4762_M4x25 x 6
ISO4762_M2.5x14 x 8
ISO10642_M4x16 x 2
ISO4032_Tuerca_M4 x 2
E-02_Base_cincho_M3_15x15
ISO4762_M3x12
ISO4032_Tuerca_M3
ISO4762_M4x12 x 6
