Ulimanopano/Robot-6GDL/Robot_6GDL_V11/02_Piezas/10_Motores/GIM3505-36.SLDPRT

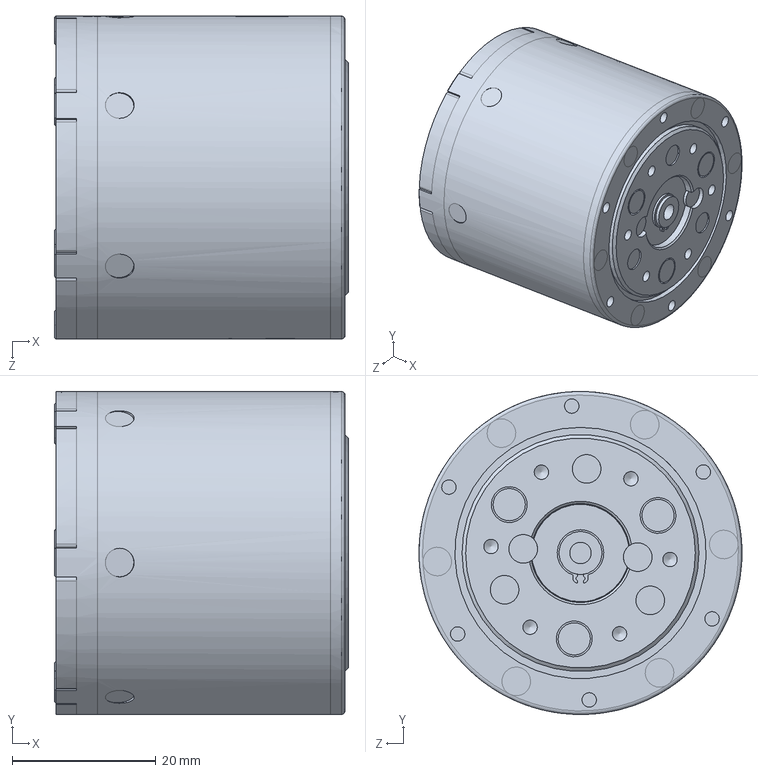
[picture p22: CAD file, 2026-11-11]
Robot_6GDL_V11/02_Piezas/10_Motores/GIM3505-36.SLDPRT
41.0 x 45.0 x 45.0 mm
