Ulimanopano/Robot-6GDL/Robot_6GDL_V11/02_Piezas/L2-01_Placa_brazo_motor_J3.SLDPRT

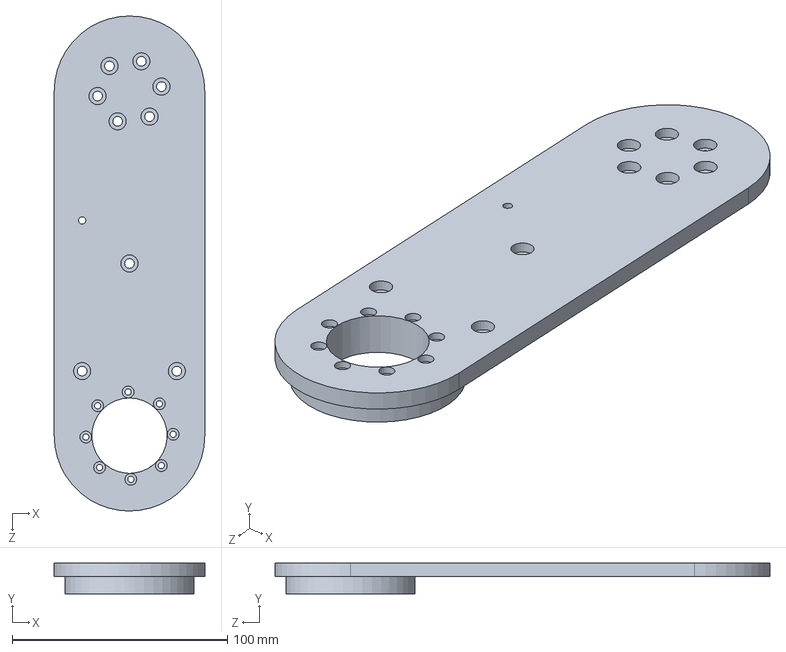
[picture p23: CAD file, 2026-11-11]
Robot_6GDL_V11/02_Piezas/L2-01_Placa_brazo_motor_J3.SLDPRT
70.0 x 14.4 x 230.0 mm
