Ulimanopano/Robot-6GDL/Robot_6GDL_V11/05_Matlab/V11_link_3.step

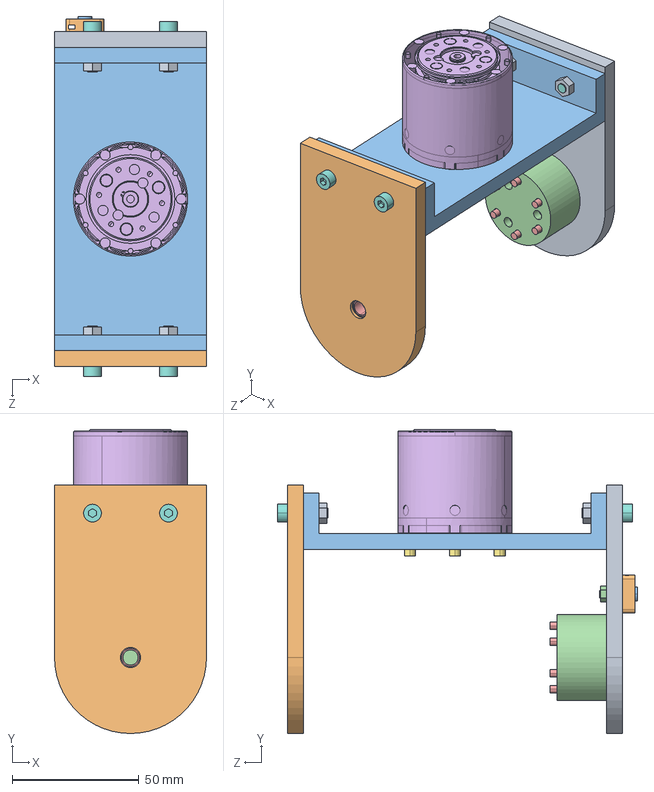
[picture p24: CAD file, 2026-11-11]
Robot_6GDL_V11/05_Matlab/V11_link_3.step
60.0 x 120.0 x 142.2 mm
L3-01_Placa_antebrazo_cubo_J3
L3-02_Placa_antebrazo_balero_J3
L3-03_Repisa_motor_J4
L3-04_Cubo_J3
balero 696zz
GIM3505-36
ISO4762_M2.5x10 x 6
ISO4762_M4x16 x 4
ISO4032_Tuerca_M4 x 4
E-02_Base_cincho_M3_15x15
ISO4762_M3x12
ISO4032_Tuerca_M3
ISO4762_M3x25 x 6
