Ulimanopano/Robot-6GDL/Robot_6GDL_V11/02_Piezas/L4-02_Pared_motor_J5.SLDPRT

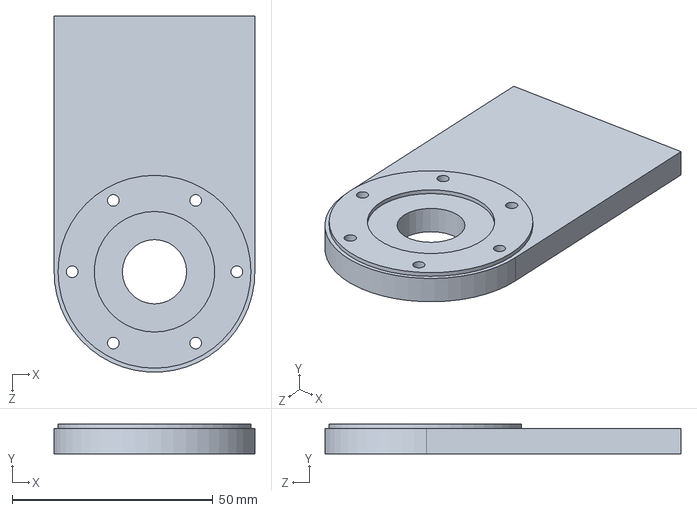
[picture p25: CAD file, 2026-11-11]
Robot_6GDL_V11/02_Piezas/L4-02_Pared_motor_J5.SLDPRT
50.0 x 7.35 x 88.6 mm
