Ulimanopano/Robot-6GDL/Robot_6GDL_V11/02_Piezas/L4-01_Disco_muneca.SLDPRT

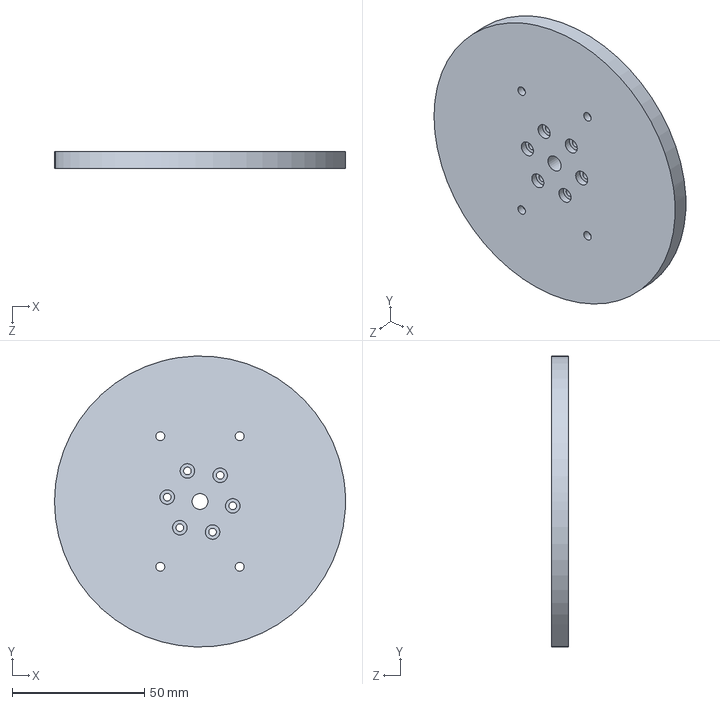
[picture p27: CAD file, 2026-11-11]
Robot_6GDL_V11/02_Piezas/L4-01_Disco_muneca.SLDPRT
110.0 x 110.0 x 6.35 mm
