Ulimanopano/Robot-6GDL/Robot_6GDL_V11/05_Matlab/V11_link_5.step

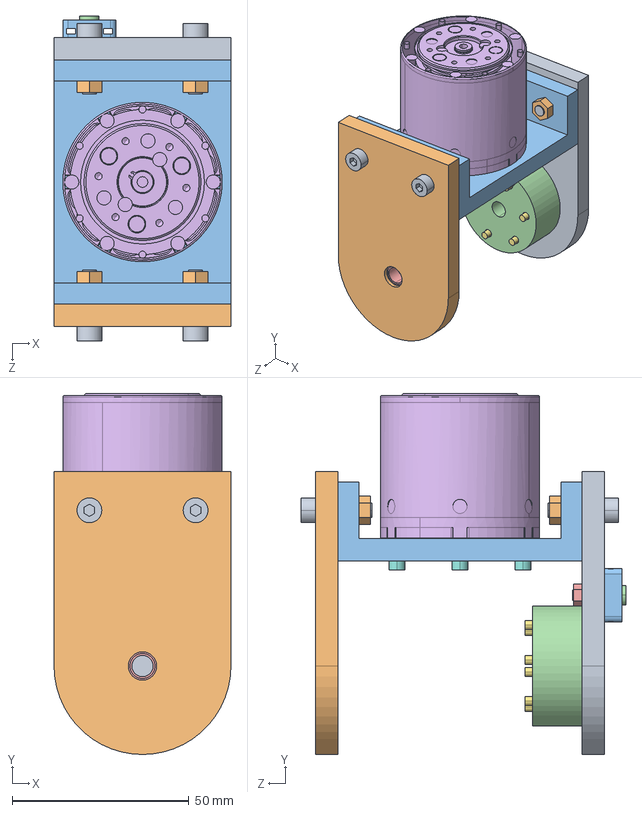
[picture p28: CAD file, 2026-11-11]
Robot_6GDL_V11/05_Matlab/V11_link_5.step
50.0 x 102.0 x 91.7 mm
L5-01_Placa_cubo_J5
L5-02_Placa_balero_J5
L5-03_Repisa_motor_J6
L5-04_Cubo_J5
balero 696zz
GIM3505-36
ISO4762_M2.5x20 x 6
ISO4762_M2.5x10 x 6
ISO4762_M4x16 x 4
ISO4032_Tuerca_M4 x 4
E-02_Base_cincho_M3_15x15
ISO4762_M3x12
ISO4032_Tuerca_M3
