Ulimanopano/Robot-6GDL/Robot_6GDL_V11/02_Piezas/L3-02_Placa_antebrazo_balero_J3.SLDPRT

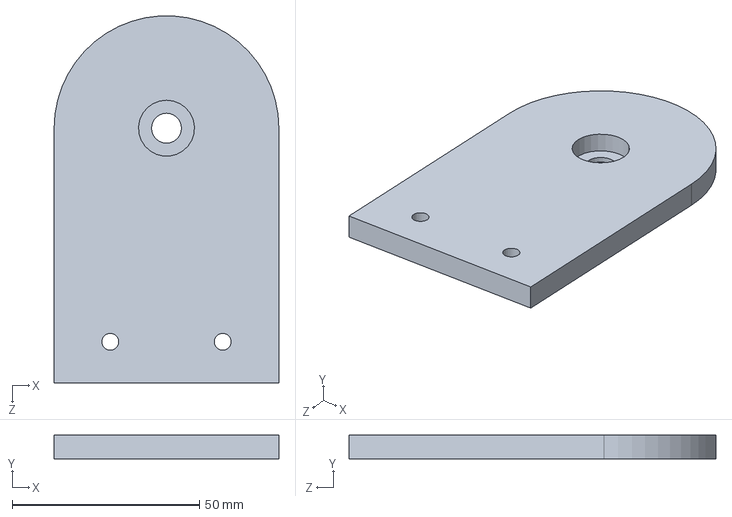
[picture p29: CAD file, 2026-11-11]
Robot_6GDL_V11/02_Piezas/L3-02_Placa_antebrazo_balero_J3.SLDPRT
60.0 x 6.35 x 97.9 mm
