Ulimanopano/Robot-6GDL/Robot_6GDL_V11/05_Matlab/V11_link_6.step

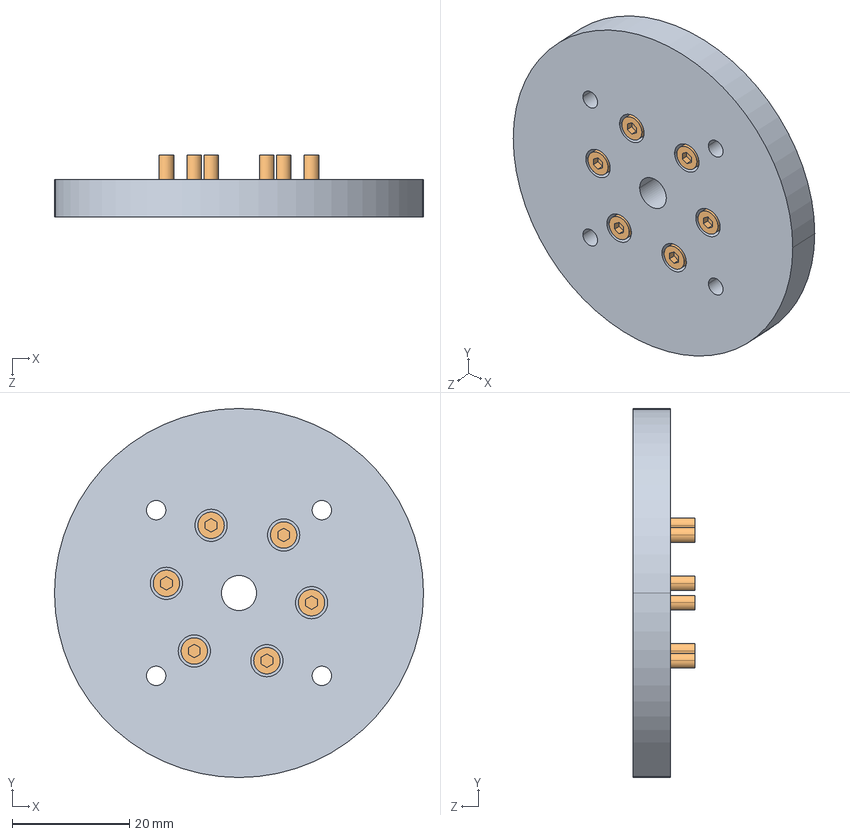
[picture p30: CAD file, 2026-11-11]
Robot_6GDL_V11/05_Matlab/V11_link_6.step
63.0 x 63.0 x 10.5 mm
L6-01_Brida_herramienta
ISO4762_M2.5x8 x 6
