Ulimanopano/Robot-6GDL/Robot_6GDL_V11/02_Piezas/B04_Cubierta_balero_J1.SLDPRT

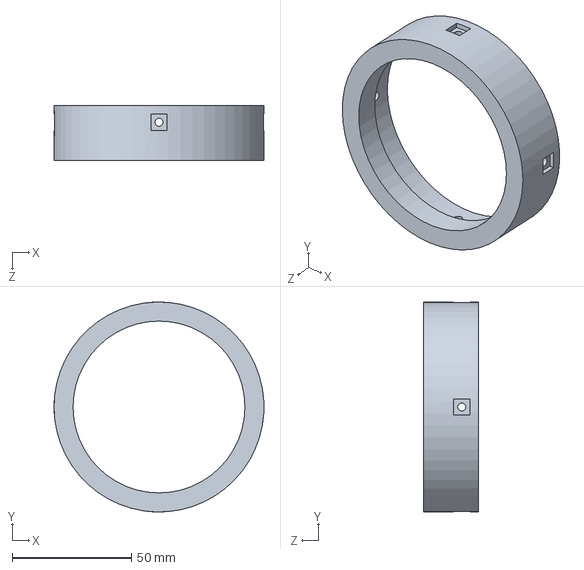
[picture p31: CAD file, 2026-11-11]
Robot_6GDL_V11/02_Piezas/B04_Cubierta_balero_J1.SLDPRT
88.0 x 88.0 x 23.0 mm
