Ulimanopano/Robot-6GDL/Robot_6GDL_V11/05_Matlab/V11_link_4.step

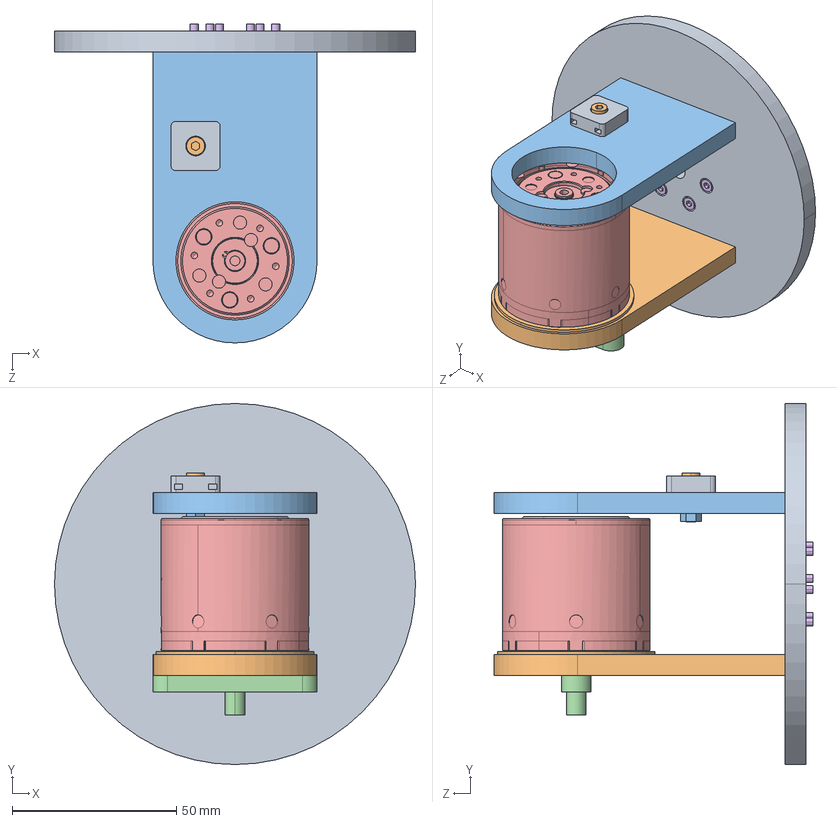
[picture p32: CAD file, 2026-11-11]
Robot_6GDL_V11/05_Matlab/V11_link_4.step
110.0 x 110.0 x 97.2 mm
L4-01_Disco_muneca
L4-02_Pared_motor_J5
L4-03_Pared_paso_J5
EF-J5_Ejefalso
GIM3505-36
ISO4762_M2.5x6 x 6
ISO4762_M2.5x8 x 4
ISO4762_M2.5x14 x 2
E-02_Base_cincho_M3_15x15
ISO4762_M3x12
ISO4032_Tuerca_M3
ISO4762_M3x10 x 4
