Ulimanopano/Robot-6GDL/Robot_6GDL_V11/02_Piezas/B01_Placa_base.SLDPRT

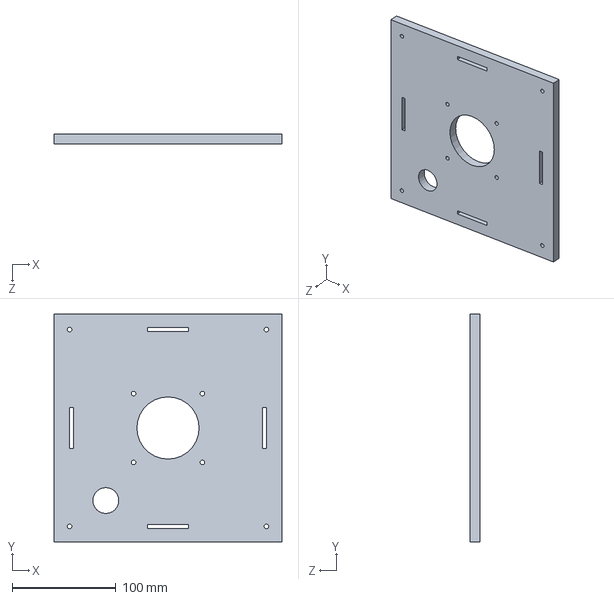
[picture p33: CAD file, 2026-11-11]
Robot_6GDL_V11/02_Piezas/B01_Placa_base.SLDPRT
220.0 x 220.0 x 10.0 mm
