Ulimanopano/Robot-6GDL/Robot_6GDL_V11/02_Piezas/B03_Fondo_caja.SLDPRT

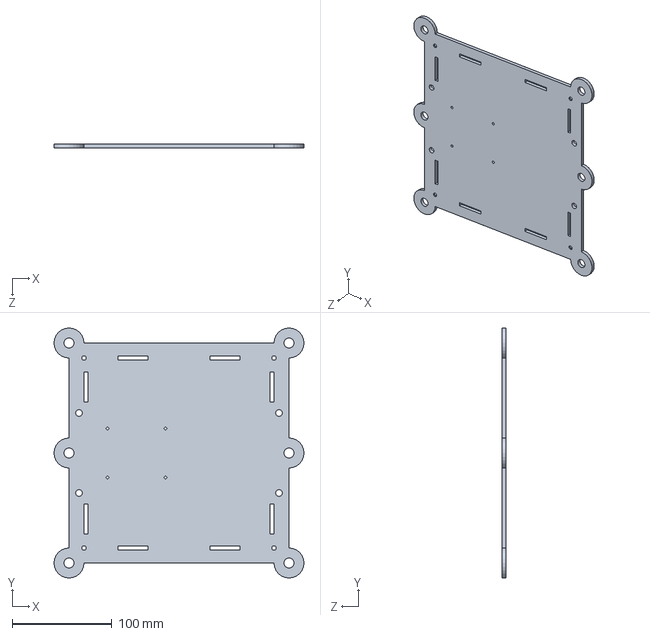
[picture p34: CAD file, 2026-11-11]
Robot_6GDL_V11/02_Piezas/B03_Fondo_caja.SLDPRT
250.0 x 250.0 x 4.00 mm
