Ulimanopano/Robot-6GDL/Robot_6GDL_V11/02_Piezas/L2-02_Placa_brazo_balero_J2.SLDPRT

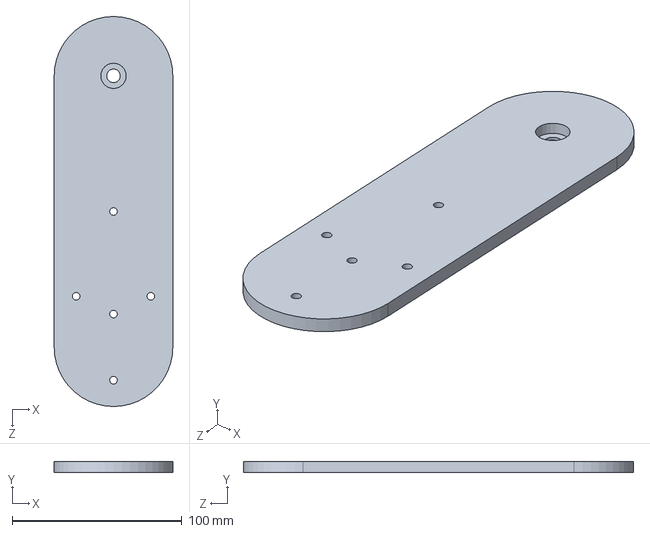
[picture p35: CAD file, 2026-11-11]
Robot_6GDL_V11/02_Piezas/L2-02_Placa_brazo_balero_J2.SLDPRT
70.0 x 6.35 x 230.0 mm
