Ulimanopano/Robot-6GDL/Robot_6GDL_V11/02_Piezas/12_Tornilleria/Separador_hex_M2.5x10.SLDPRT

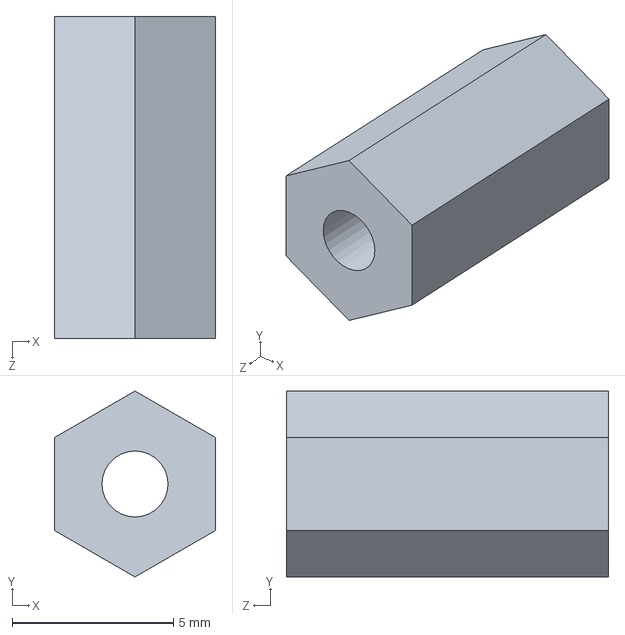
[picture p36: CAD file, 2026-11-11]
Robot_6GDL_V11/02_Piezas/12_Tornilleria/Separador_hex_M2.5x10.SLDPRT
5.00 x 5.77 x 10.0 mm
