Ulimanopano/Robot-6GDL/Robot_6GDL_V11/02_Piezas/L1-02_Pared_motor_J2.SLDPRT

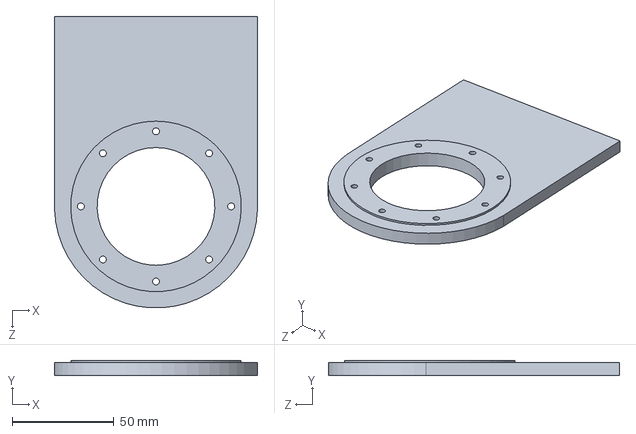
[picture p37: CAD file, 2026-11-11]
Robot_6GDL_V11/02_Piezas/L1-02_Pared_motor_J2.SLDPRT
100.0 x 7.35 x 143.6 mm
