Ulimanopano/Robot-6GDL/Robot_6GDL_V11/02_Piezas/EF-J3_Ejefalso.SLDPRT

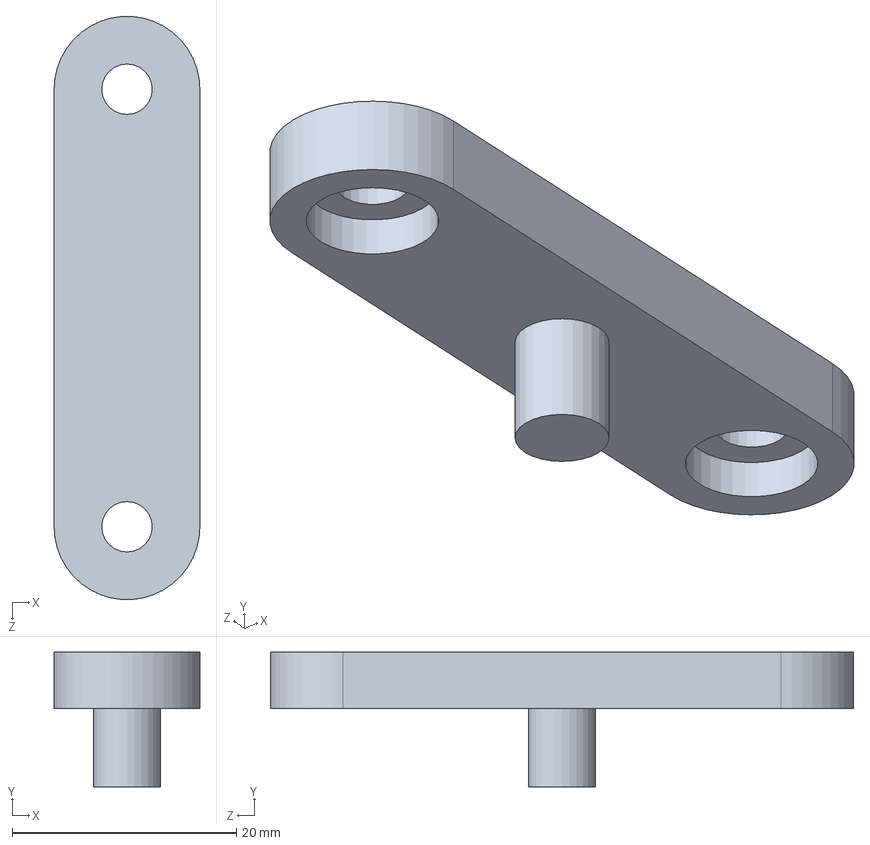
[picture p38: CAD file, 2026-11-11]
Robot_6GDL_V11/02_Piezas/EF-J3_Ejefalso.SLDPRT
13.0 x 12.0 x 52.0 mm
