Ulimanopano/Robot-6GDL/Robot_6GDL_V11/02_Piezas/L2-03_Cubo_J2.SLDPRT

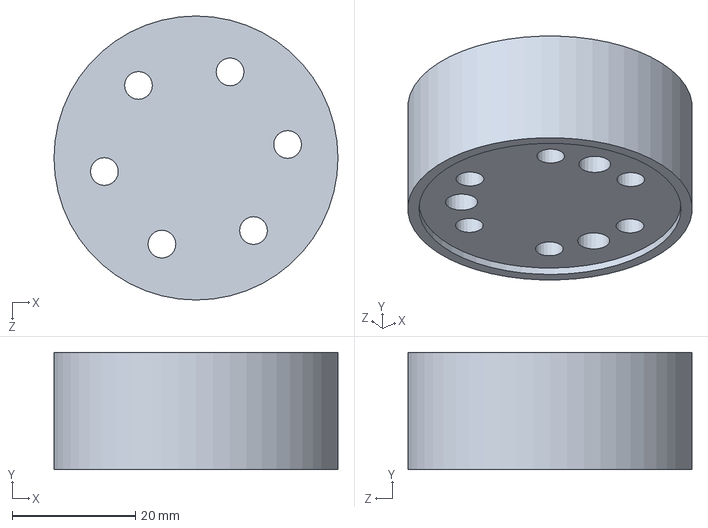
[picture p39: CAD file, 2026-11-11]
Robot_6GDL_V11/02_Piezas/L2-03_Cubo_J2.SLDPRT
46.0 x 19.0 x 46.0 mm
