Ulimanopano/Robot-6GDL/Robot_6GDL_V11/02_Piezas/L4-03_Pared_paso_J5.SLDPRT

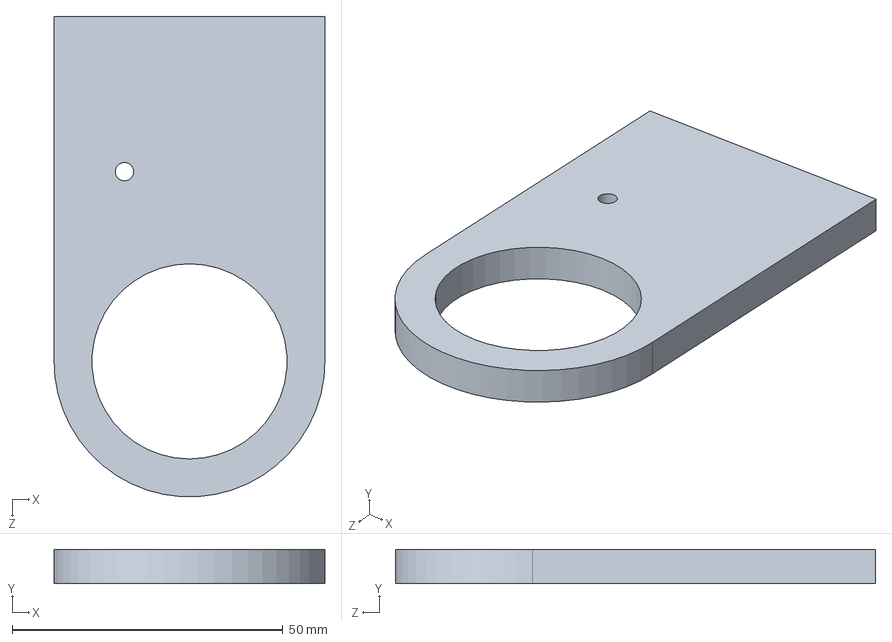
[picture p40: CAD file, 2026-11-11]
Robot_6GDL_V11/02_Piezas/L4-03_Pared_paso_J5.SLDPRT
50.0 x 6.35 x 88.6 mm
