Ulimanopano/Robot-6GDL/Robot_6GDL_V11/02_Piezas/L2-04_Separador_D12.SLDPRT

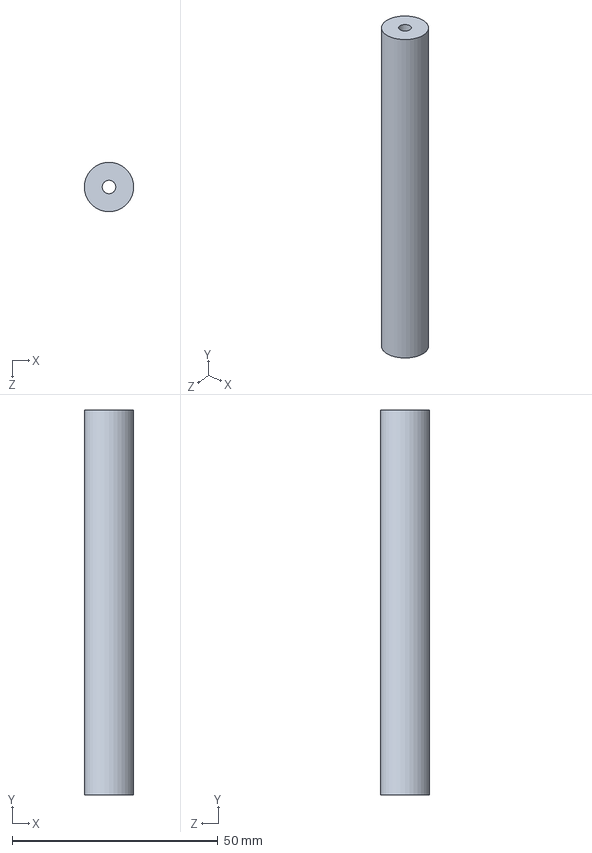
[picture p41: CAD file, 2026-11-11]
Robot_6GDL_V11/02_Piezas/L2-04_Separador_D12.SLDPRT
12.0 x 93.5 x 12.0 mm
