Ulimanopano/Robot-6GDL/Robot_6GDL_V11/02_Piezas/L5-02_Placa_balero_J5.SLDPRT

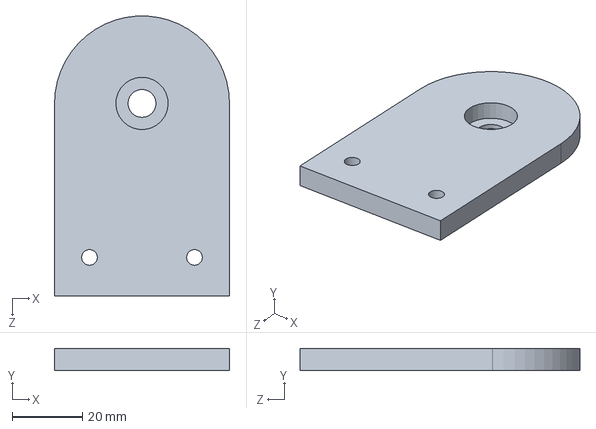
[picture p42: CAD file, 2026-11-11]
Robot_6GDL_V11/02_Piezas/L5-02_Placa_balero_J5.SLDPRT
50.0 x 6.35 x 80.0 mm
