Ulimanopano/Robot-6GDL/Robot_6GDL_V11/02_Piezas/L1-03_Pared_paso_J2.SLDPRT

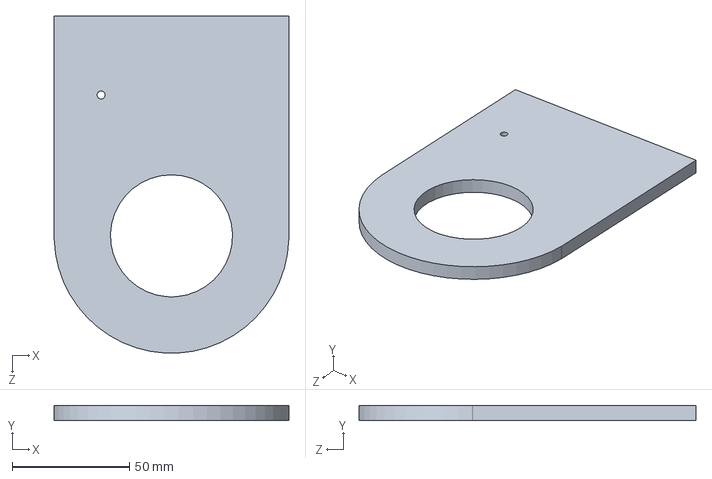
[picture p43: CAD file, 2026-11-11]
Robot_6GDL_V11/02_Piezas/L1-03_Pared_paso_J2.SLDPRT
100.0 x 6.35 x 143.6 mm
