Ulimanopano/Robot-6GDL/Robot_6GDL_V11/02_Piezas/L1-01_Disco_torreta.SLDPRT

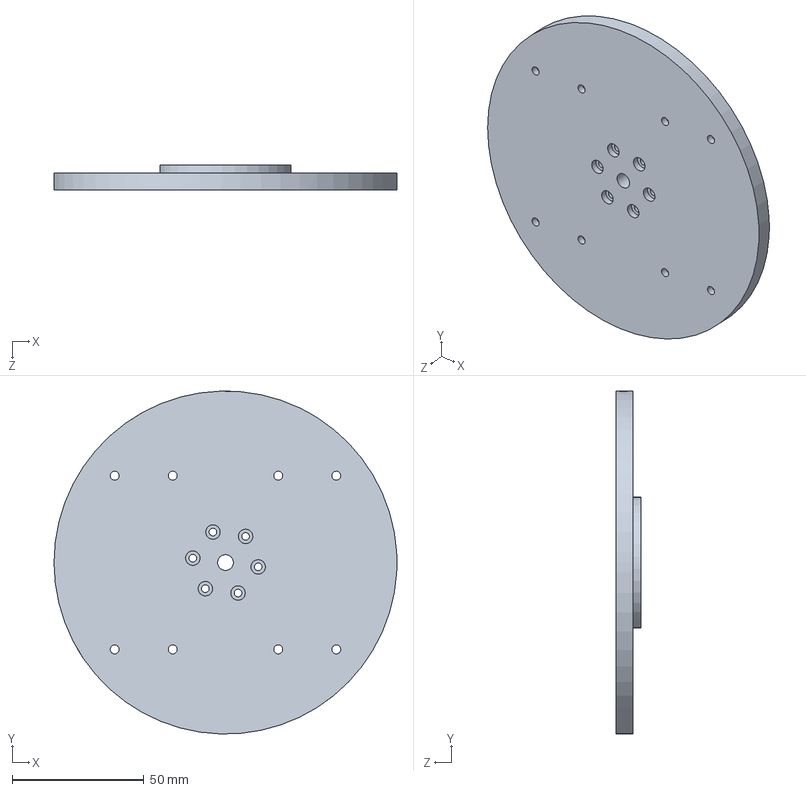
[picture p44: CAD file, 2026-11-11]
Robot_6GDL_V11/02_Piezas/L1-01_Disco_torreta.SLDPRT
130.0 x 130.0 x 9.35 mm
