Ulimanopano/Robot-6GDL/Robot_6GDL_V11/02_Piezas/B05_Pared_caja.SLDPRT

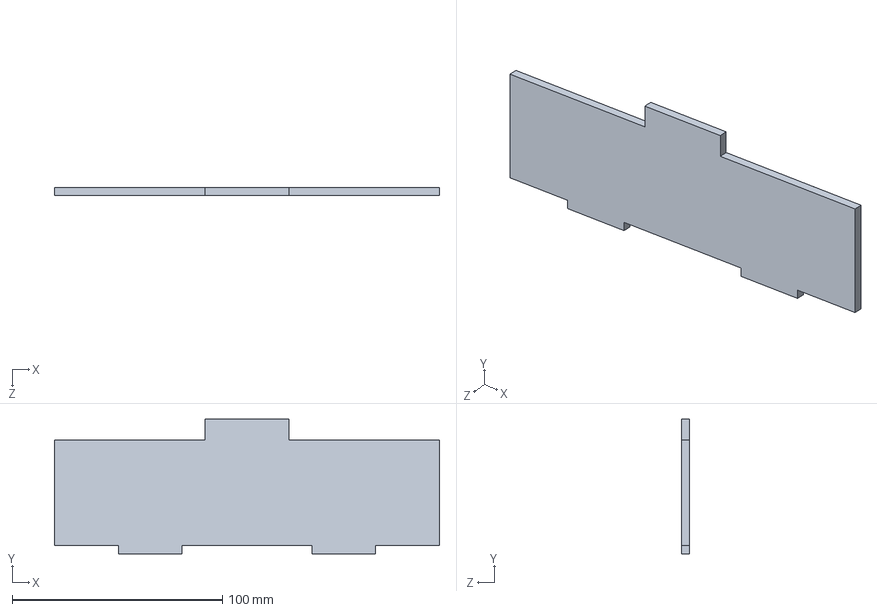
[picture p45: CAD file, 2026-11-11]
Robot_6GDL_V11/02_Piezas/B05_Pared_caja.SLDPRT
183.0 x 64.0 x 4.00 mm
