Ulimanopano/Robot-6GDL/Robot_6GDL_V11/02_Piezas/L3-03_Repisa_motor_J4.SLDPRT

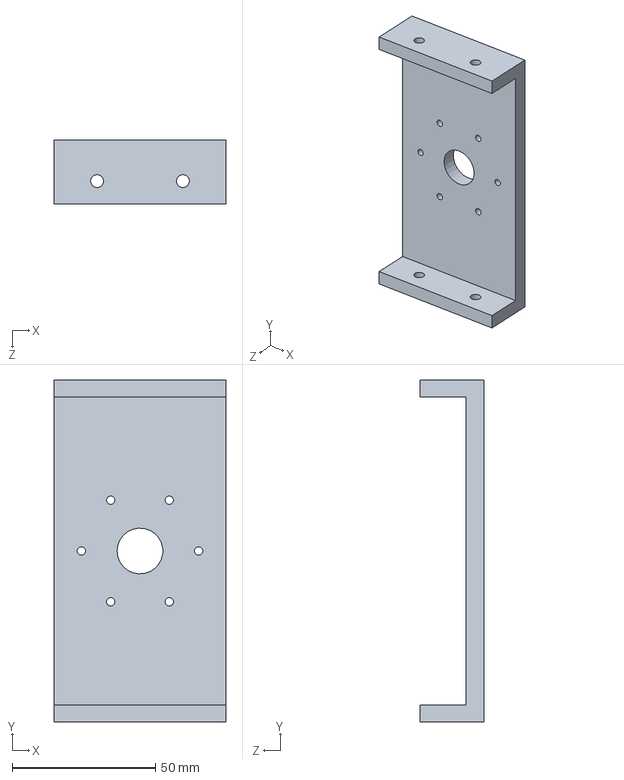
[picture p46: CAD file, 2026-11-11]
Robot_6GDL_V11/02_Piezas/L3-03_Repisa_motor_J4.SLDPRT
60.0 x 119.5 x 22.4 mm
