Ulimanopano/Robot-6GDL/Robot_6GDL_V11/02_Piezas/L6-01_Brida_herramienta.SLDPRT

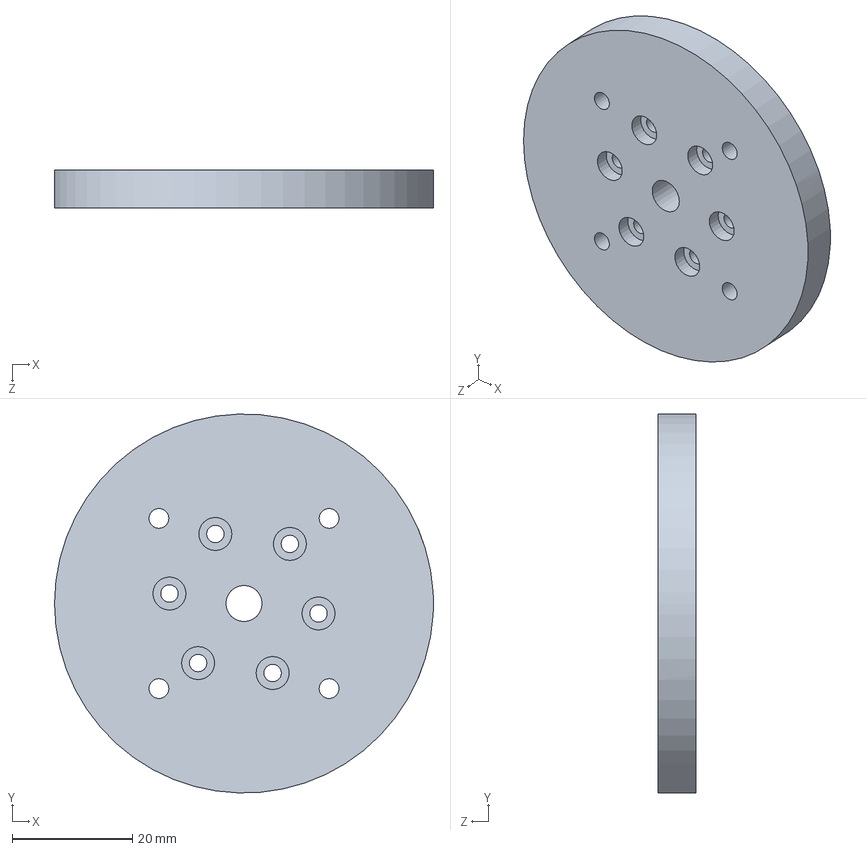
[picture p48: CAD file, 2026-11-11]
Robot_6GDL_V11/02_Piezas/L6-01_Brida_herramienta.SLDPRT
63.0 x 63.0 x 6.35 mm
