Ulimanopano/Robot-6GDL/Robot_6GDL_V11/02_Piezas/L5-04_Cubo_J5.SLDPRT

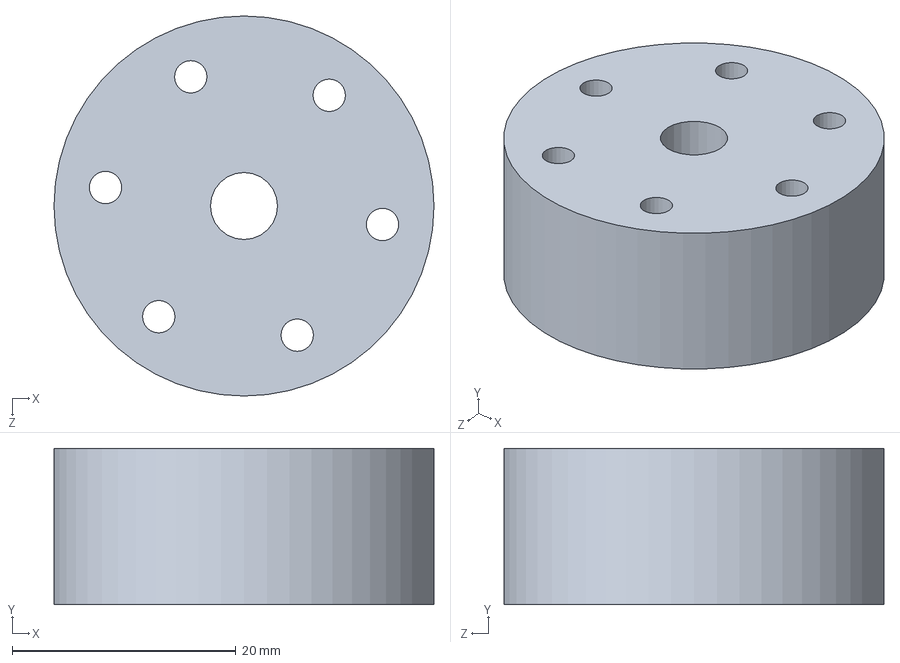
[picture p49: CAD file, 2026-11-11]
Robot_6GDL_V11/02_Piezas/L5-04_Cubo_J5.SLDPRT
34.0 x 14.0 x 34.0 mm
