Ulimanopano/Robot-6GDL/Robot_6GDL_V11/02_Piezas/EF-J2_Ejefalso.SLDPRT

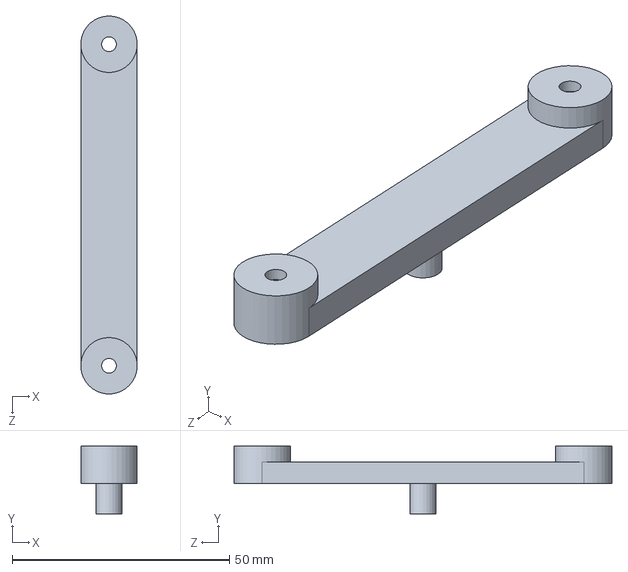
[picture p50: CAD file, 2026-11-11]
Robot_6GDL_V11/02_Piezas/EF-J2_Ejefalso.SLDPRT
13.0 x 15.7 x 87.0 mm
