Ulimanopano/Robot-6GDL/Robot_6GDL_V11/02_Piezas/EF-J5_Ejefalso.SLDPRT

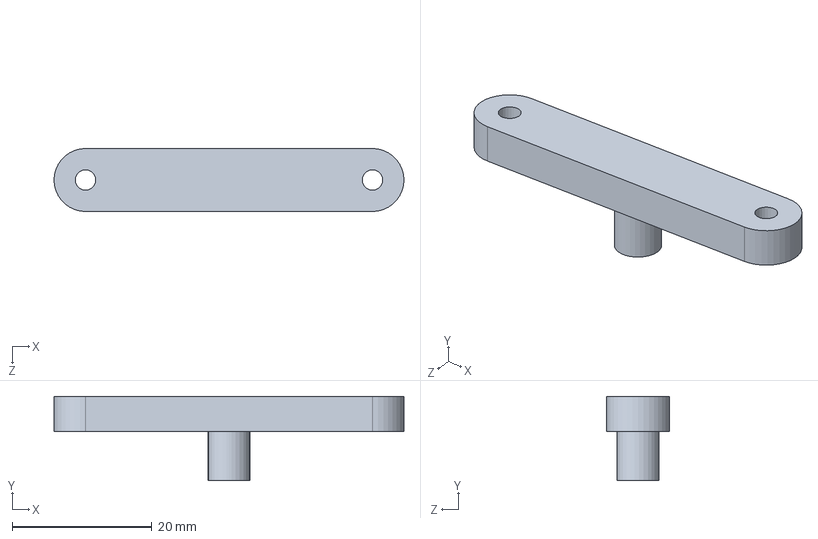
[picture p51: CAD file, 2026-11-11]
Robot_6GDL_V11/02_Piezas/EF-J5_Ejefalso.SLDPRT
50.0 x 12.0 x 9.00 mm
