Ulimanopano/Robot-6GDL/Robot_6GDL_V11/02_Piezas/B07_Pared_caja_x.SLDPRT

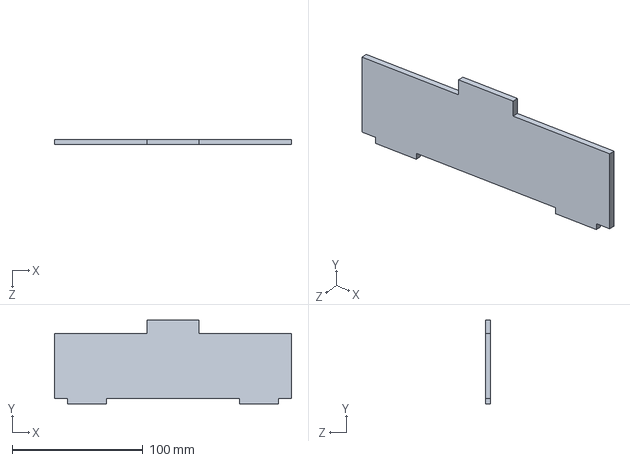
[picture p52: CAD file, 2026-11-11]
Robot_6GDL_V11/02_Piezas/B07_Pared_caja_x.SLDPRT
181.6 x 64.0 x 4.00 mm
