Ulimanopano/Robot-6GDL/Robot_6GDL_V11/02_Piezas/L3-04_Cubo_J3.SLDPRT

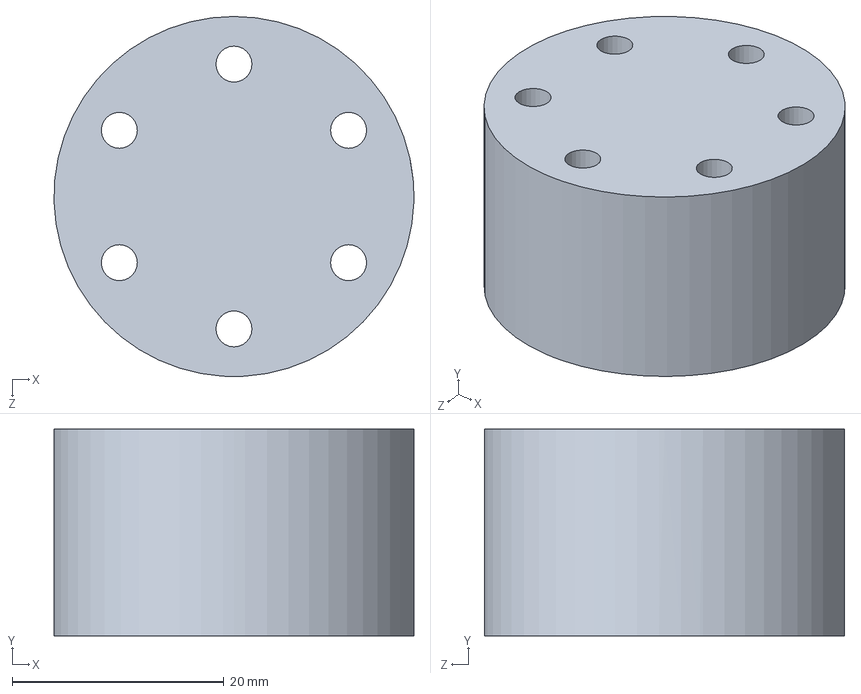
[picture p53: CAD file, 2026-11-11]
Robot_6GDL_V11/02_Piezas/L3-04_Cubo_J3.SLDPRT
34.0 x 19.5 x 34.0 mm
