Ulimanopano/Robot-6GDL/Robot_6GDL_V11/02_Piezas/B02_Pedestal_J1.SLDPRT

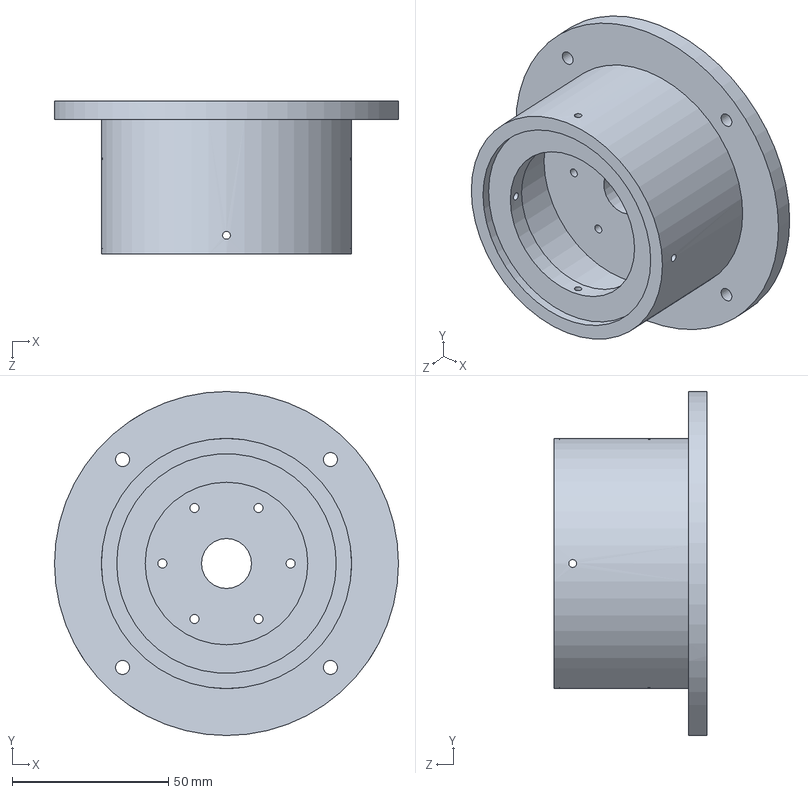
[picture p54: CAD file, 2026-11-11]
Robot_6GDL_V11/02_Piezas/B02_Pedestal_J1.SLDPRT
110.0 x 110.0 x 49.0 mm
