Ulimanopano/Robot-6GDL/Robot_6GDL_V11/01_Links/link_6.SLDASM

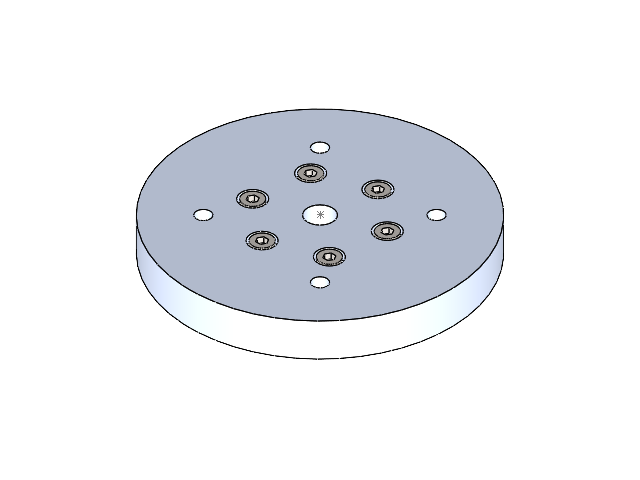
[picture p55: CAD file, 2026-11-11]
Robot_6GDL_V11/01_Links/link_6.SLDASM
L6-01_Brida_herramienta
ISO4762_M2.5x8 x 6
