Ulimanopano/Robot-6GDL/Robot_6GDL_V11/Robot_6GDL_V11.SLDASM

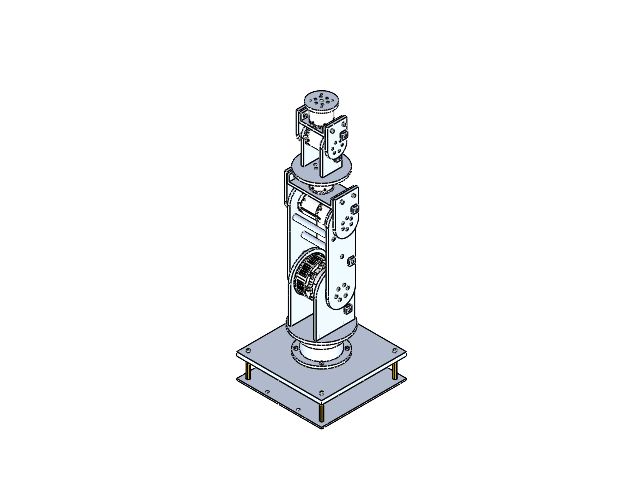
[picture p56: CAD file, 2026-11-11]
Robot_6GDL_V11/Robot_6GDL_V11.SLDASM
B01_Placa_base
B02_Pedestal_J1
GIM3505-36 x 4
R-04_Balero_axial_NSK_51110
ISO4762_M2.5x10 x 18
ISO4762_M4x16 x 16
ISO4032_Tuerca_M4 x 14
B03_Fondo_caja
E-03_Raspberry_Pi_5
Separador_hex_M4x50 x 4
ISO10642_M4x10 x 4
Separador_hex_M2.5x10 x 4
ISO10642_M2.5x8 x 4
ISO4762_M2.5x6 x 10
B04_Cubierta_balero_J1
ISO4762_M3x12 x 14
B05_Pared_caja x 2
B06_Pared_caja_puertos
B07_Pared_caja_x
L1-01_Disco_torreta
L1-02_Pared_motor_J2
L1-03_Pared_paso_J2
GIM6010-48
EF-J2_Ejefalso
ISO4762_M2.5x8 x 16
E-02_Base_cincho_M3_15x15 x 5
ISO4762_M3x16
ISO4032_Tuerca_M3 x 5
ISO4762_M3x14 x 2
ISO4762_M3x10 x 12
L2-01_Placa_brazo_motor_J3
L2-02_Placa_brazo_balero_J2
L2-03_Cubo_J2
L2-04_Separador_D12 x 3
balero 696zz x 3
GIM3510-64
EF-J3_Ejefalso
ISO4762_M4x25 x 6
ISO4762_M2.5x14 x 10
ISO10642_M4x16 x 2
ISO4762_M4x12 x 6
L3-01_Placa_antebrazo_cubo_J3
L3-02_Placa_antebrazo_balero_J3
L3-03_Repisa_motor_J4
L3-04_Cubo_J3
ISO4762_M3x25 x 6
L4-01_Disco_muneca
L4-02_Pared_motor_J5
L4-03_Pared_paso_J5
EF-J5_Ejefalso
L5-01_Placa_cubo_J5
L5-02_Placa_balero_J5
L5-03_Repisa_motor_J6
L5-04_Cubo_J5
ISO4762_M2.5x20 x 6
L6-01_Brida_herramienta
