Ulimanopano/Robot-6GDL/Robot_6GDL_V11/01_Links/base_link.SLDASM

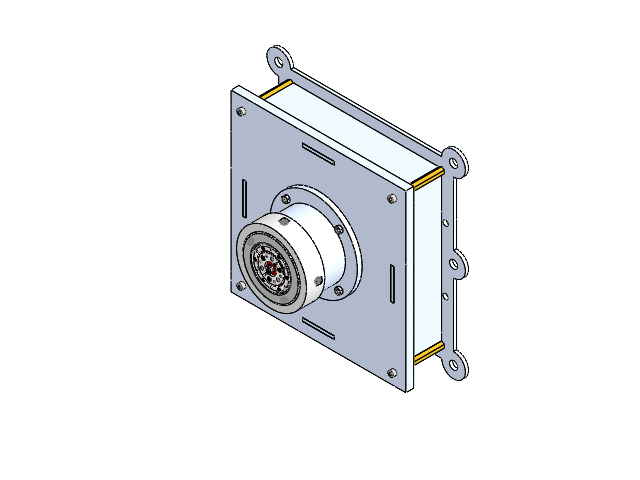
[picture p57: CAD file, 2026-11-11]
Robot_6GDL_V11/01_Links/base_link.SLDASM
B01_Placa_base
B02_Pedestal_J1
GIM3505-36
R-04_Balero_axial_NSK_51110
ISO4762_M2.5x10 x 6
ISO4762_M4x16 x 8
ISO4032_Tuerca_M4 x 4
B03_Fondo_caja
E-03_Raspberry_Pi_5
Separador_hex_M4x50 x 4
ISO10642_M4x10 x 4
Separador_hex_M2.5x10 x 4
ISO10642_M2.5x8 x 4
ISO4762_M2.5x6 x 4
B04_Cubierta_balero_J1
ISO4762_M3x12 x 4
B05_Pared_caja x 2
B06_Pared_caja_puertos
B07_Pared_caja_x
