Ulimanopano/Robot-6GDL/Robot_6GDL_V11/01_Links/link_1.SLDASM

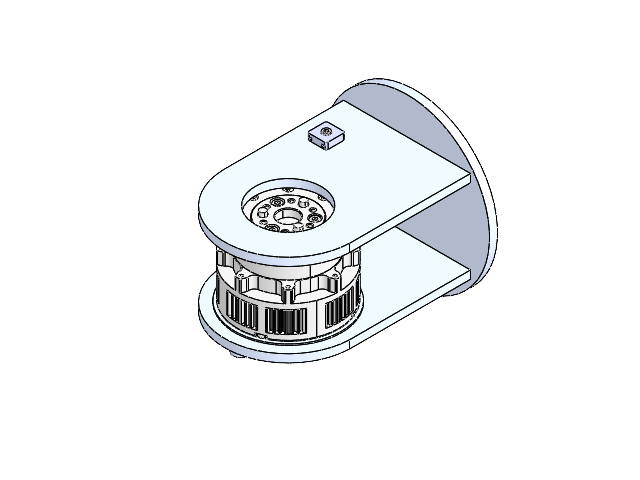
[picture p60: CAD file, 2026-11-11]
Robot_6GDL_V11/01_Links/link_1.SLDASM
L1-01_Disco_torreta
L1-02_Pared_motor_J2
L1-03_Pared_paso_J2
GIM6010-48
EF-J2_Ejefalso
ISO4762_M2.5x8 x 6
E-02_Base_cincho_M3_15x15
ISO4762_M3x16
ISO4032_Tuerca_M3
ISO4762_M3x12 x 6
ISO4762_M3x14 x 2
ISO4762_M3x10 x 8
