Ulimanopano/Robot-6GDL/(list of files, cad)

Other CAD files:
Robot_6GDL_V11/02_Piezas/L3-01_Placa_antebrazo_cubo_J3.SLDPRT
Robot_6GDL_V11/03_STEP/Tornillos_y_tuercas/Separador_hex_M2.5x10.step
Robot_6GDL_V10/01_Links/base_link.SLDASM
Robot_6GDL_V10/01_Links/link_1.SLDASM
Robot_6GDL_V10/01_Links/link_2.SLDASM
Robot_6GDL_V10/01_Links/link_3.SLDASM
Robot_6GDL_V10/01_Links/link_4.SLDASM
Robot_6GDL_V10/01_Links/link_5.SLDASM
Robot_6GDL_V10/01_Links/link_6.SLDASM
Robot_6GDL_V10/02_Piezas/10_Motores/GIM3505-36.SLDPRT
Robot_6GDL_V10/02_Piezas/10_Motores/GIM3510-64.SLDPRT
Robot_6GDL_V10/02_Piezas/10_Motores/GIM6010-48.SLDPRT
Robot_6GDL_V10/02_Piezas/11_Baleros/R-04_Balero_axial_NSK_51110.SLDPRT
Robot_6GDL_V10/02_Piezas/11_Baleros/balero 696zz.SLDPRT
Robot_6GDL_V10/02_Piezas/12_Tornilleria/ISO10642_M2.5x8.SLDPRT
Robot_6GDL_V10/02_Piezas/12_Tornilleria/ISO10642_M4x10.SLDPRT
Robot_6GDL_V10/02_Piezas/12_Tornilleria/ISO10642_M4x16.SLDPRT
Robot_6GDL_V10/02_Piezas/12_Tornilleria/ISO4032_Tuerca_M3.SLDPRT
Robot_6GDL_V10/02_Piezas/12_Tornilleria/ISO4032_Tuerca_M4.SLDPRT
Robot_6GDL_V10/02_Piezas/12_Tornilleria/ISO4762_M2.5x10.SLDPRT
Robot_6GDL_V10/02_Piezas/12_Tornilleria/ISO4762_M2.5x14.SLDPRT
Robot_6GDL_V10/02_Piezas/12_Tornilleria/ISO4762_M2.5x16.SLDPRT
Robot_6GDL_V10/02_Piezas/12_Tornilleria/ISO4762_M2.5x20.SLDPRT
Robot_6GDL_V10/02_Piezas/12_Tornilleria/ISO4762_M2.5x6.SLDPRT
Robot_6GDL_V10/02_Piezas/12_Tornilleria/ISO4762_M2.5x8.SLDPRT
Robot_6GDL_V10/02_Piezas/12_Tornilleria/ISO4762_M3x12.SLDPRT
Robot_6GDL_V10/02_Piezas/12_Tornilleria/ISO4762_M3x14.SLDPRT
Robot_6GDL_V10/02_Piezas/12_Tornilleria/ISO4762_M3x16.SLDPRT
Robot_6GDL_V10/02_Piezas/12_Tornilleria/ISO4762_M3x20.SLDPRT
Robot_6GDL_V10/02_Piezas/12_Tornilleria/ISO4762_M3x25.SLDPRT
Robot_6GDL_V10/02_Piezas/12_Tornilleria/ISO4762_M4x16.SLDPRT
Robot_6GDL_V10/02_Piezas/12_Tornilleria/ISO4762_M4x20.SLDPRT
Robot_6GDL_V10/02_Piezas/12_Tornilleria/ISO4762_M4x25.SLDPRT
Robot_6GDL_V10/02_Piezas/12_Tornilleria/Separador_hex_M2.5x10.SLDPRT
Robot_6GDL_V10/02_Piezas/12_Tornilleria/Separador_hex_M4x50.SLDPRT
Robot_6GDL_V10/02_Piezas/12_Tornilleria/Varilla_roscada_M4x114.SLDPRT
Robot_6GDL_V10/02_Piezas/13_Perfiles/Angulo_Al_3-4x3-4x1-8_L20.SLDPRT
Robot_6GDL_V10/02_Piezas/14_Electronica/E-02_Base_cincho_M3_15x15.SLDPRT
Robot_6GDL_V10/02_Piezas/14_Electronica/E-03_Raspberry_Pi_5.SLDPRT
Robot_6GDL_V10/02_Piezas/B01_Placa_base.SLDPRT
Robot_6GDL_V10/02_Piezas/B02_Pedestal_J1.SLDPRT
Robot_6GDL_V10/02_Piezas/B03_Fondo_caja.SLDPRT
Robot_6GDL_V10/02_Piezas/EF-J2_Ejefalso.SLDPRT
Robot_6GDL_V10/02_Piezas/EF-J3_Ejefalso.SLDPRT
Robot_6GDL_V10/02_Piezas/EF-J5_Ejefalso.SLDPRT
Robot_6GDL_V10/02_Piezas/L1-01_Disco_torreta.SLDPRT
Robot_6GDL_V10/02_Piezas/L1-02_Pared_motor_J2.SLDPRT
Robot_6GDL_V10/02_Piezas/L1-03_Pared_paso_J2.SLDPRT
Robot_6GDL_V10/02_Piezas/L2-01_Placa_brazo_motor_J3.SLDPRT
Robot_6GDL_V10/02_Piezas/L2-02_Placa_brazo_balero_J2.SLDPRT
Robot_6GDL_V10/02_Piezas/L2-03_Cubo_J2.SLDPRT
Robot_6GDL_V10/02_Piezas/L2-04_Separador_D12.SLDPRT
Robot_6GDL_V10/02_Piezas/L3-01_Placa_antebrazo_cubo_J3.SLDPRT
Robot_6GDL_V10/02_Piezas/L3-02_Placa_antebrazo_balero_J3.SLDPRT
Robot_6GDL_V10/02_Piezas/L3-03_Repisa_motor_J4.SLDPRT
Robot_6GDL_V10/02_Piezas/L3-04_Cubo_J3.SLDPRT
Robot_6GDL_V10/02_Piezas/L4-01_Disco_muneca.SLDPRT
Robot_6GDL_V10/02_Piezas/L4-02_Pared_motor_J5.SLDPRT
Robot_6GDL_V10/02_Piezas/L4-03_Pared_paso_J5.SLDPRT
Robot_6GDL_V10/02_Piezas/L5-01_Placa_cubo_J5.SLDPRT
Robot_6GDL_V10/02_Piezas/L5-02_Placa_balero_J5.SLDPRT
Robot_6GDL_V10/02_Piezas/L5-03_Repisa_motor_J6.SLDPRT
Robot_6GDL_V10/02_Piezas/L5-04_Cubo_J5.SLDPRT
Robot_6GDL_V10/02_Piezas/L6-01_Brida_herramienta.SLDPRT
Robot_6GDL_V10/03_STEP/Motores/GIM3505-36_doble_encoder.stp
Robot_6GDL_V10/03_STEP/Motores/GIM3505-36_sin_driver.stp
Robot_6GDL_V10/03_STEP/Motores/GIM3510-64.stp
Robot_6GDL_V10/03_STEP/Motores/GIM6010-48.stp
Robot_6GDL_V10/03_STEP/Tornillos_y_tuercas/ISO10642_M2.5x8.step
Robot_6GDL_V10/03_STEP/Tornillos_y_tuercas/ISO10642_M4x10.step
Robot_6GDL_V10/03_STEP/Tornillos_y_tuercas/ISO10642_M4x16.step
Robot_6GDL_V10/03_STEP/Tornillos_y_tuercas/ISO4032_Tuerca_M3.step
Robot_6GDL_V10/03_STEP/Tornillos_y_tuercas/ISO4032_Tuerca_M4.step
Robot_6GDL_V10/03_STEP/Tornillos_y_tuercas/ISO4762_M2.5x10.step
Robot_6GDL_V10/03_STEP/Tornillos_y_tuercas/ISO4762_M2.5x14.step
Robot_6GDL_V10/03_STEP/Tornillos_y_tuercas/ISO4762_M2.5x16.step
Robot_6GDL_V10/03_STEP/Tornillos_y_tuercas/ISO4762_M2.5x20.step
Robot_6GDL_V10/03_STEP/Tornillos_y_tuercas/ISO4762_M2.5x6.step
Robot_6GDL_V10/03_STEP/Tornillos_y_tuercas/ISO4762_M2.5x8.step
Robot_6GDL_V10/03_STEP/Tornillos_y_tuercas/ISO4762_M3x12.step
Robot_6GDL_V10/03_STEP/Tornillos_y_tuercas/ISO4762_M3x14.step
Robot_6GDL_V10/03_STEP/Tornillos_y_tuercas/ISO4762_M3x16.step
Robot_6GDL_V10/03_STEP/Tornillos_y_tuercas/ISO4762_M3x20.step
Robot_6GDL_V10/03_STEP/Tornillos_y_tuercas/ISO4762_M3x25.step
Robot_6GDL_V10/03_STEP/Tornillos_y_tuercas/ISO4762_M4x16.step
Robot_6GDL_V10/03_STEP/Tornillos_y_tuercas/ISO4762_M4x20.step
Robot_6GDL_V10/03_STEP/Tornillos_y_tuercas/ISO4762_M4x25.step
Robot_6GDL_V10/03_STEP/Tornillos_y_tuercas/Separador_hex_M2.5x10.step
Robot_6GDL_V10/03_STEP/Tornillos_y_tuercas/Varilla_roscada_M4x114.step
Robot_6GDL_V10/05_Matlab/V9_2_base_link.step
Robot_6GDL_V10/05_Matlab/V9_2_link_1.step
Robot_6GDL_V10/05_Matlab/V9_2_link_2.step
Robot_6GDL_V10/05_Matlab/V9_2_link_3.step
Robot_6GDL_V10/05_Matlab/V9_2_link_4.step
Robot_6GDL_V10/05_Matlab/V9_2_link_5.step
Robot_6GDL_V10/05_Matlab/V9_2_link_6.step
Robot_6GDL_V10/Robot_6GDL_V9_2.0.SLDASM
Robot_6GDL_V11/02_Piezas/12_Tornilleria/ISO10642_M2.5x8.SLDPRT
Robot_6GDL_V11/02_Piezas/12_Tornilleria/ISO10642_M4x10.SLDPRT
Robot_6GDL_V11/02_Piezas/12_Tornilleria/ISO10642_M4x16.SLDPRT
Robot_6GDL_V11/02_Piezas/12_Tornilleria/ISO4032_Tuerca_M3.SLDPRT
Robot_6GDL_V11/02_Piezas/12_Tornilleria/ISO4032_Tuerca_M4.SLDPRT
Robot_6GDL_V11/02_Piezas/12_Tornilleria/ISO4762_M2.5x10.SLDPRT
Robot_6GDL_V11/02_Piezas/12_Tornilleria/ISO4762_M2.5x14.SLDPRT
Robot_6GDL_V11/02_Piezas/12_Tornilleria/ISO4762_M2.5x20.SLDPRT
Robot_6GDL_V11/02_Piezas/12_Tornilleria/ISO4762_M2.5x6.SLDPRT
Robot_6GDL_V11/02_Piezas/12_Tornilleria/ISO4762_M2.5x8.SLDPRT
Robot_6GDL_V11/02_Piezas/12_Tornilleria/ISO4762_M3x10.SLDPRT
Robot_6GDL_V11/02_Piezas/12_Tornilleria/ISO4762_M3x12.SLDPRT
Robot_6GDL_V11/02_Piezas/12_Tornilleria/ISO4762_M3x14.SLDPRT
Robot_6GDL_V11/02_Piezas/12_Tornilleria/ISO4762_M3x16.SLDPRT
Robot_6GDL_V11/02_Piezas/12_Tornilleria/ISO4762_M3x25.SLDPRT
Robot_6GDL_V11/02_Piezas/12_Tornilleria/ISO4762_M4x12.SLDPRT
Robot_6GDL_V11/02_Piezas/12_Tornilleria/ISO4762_M4x16.SLDPRT
Robot_6GDL_V11/02_Piezas/12_Tornilleria/ISO4762_M4x25.SLDPRT
Robot_6GDL_V11/03_STEP/Tornillos_y_tuercas/ISO10642_M2.5x8.step
Robot_6GDL_V11/03_STEP/Tornillos_y_tuercas/ISO10642_M4x10.step
Robot_6GDL_V11/03_STEP/Tornillos_y_tuercas/ISO10642_M4x16.step
Robot_6GDL_V11/03_STEP/Tornillos_y_tuercas/ISO4032_Tuerca_M3.step
Robot_6GDL_V11/03_STEP/Tornillos_y_tuercas/ISO4032_Tuerca_M4.step
Robot_6GDL_V11/03_STEP/Tornillos_y_tuercas/ISO4762_M2.5x10.step
Robot_6GDL_V11/03_STEP/Tornillos_y_tuercas/ISO4762_M2.5x14.step
Robot_6GDL_V11/03_STEP/Tornillos_y_tuercas/ISO4762_M2.5x20.step
Robot_6GDL_V11/03_STEP/Tornillos_y_tuercas/ISO4762_M2.5x6.step
Robot_6GDL_V11/03_STEP/Tornillos_y_tuercas/ISO4762_M2.5x8.step
Robot_6GDL_V11/03_STEP/Tornillos_y_tuercas/ISO4762_M3x10.step
Robot_6GDL_V11/03_STEP/Tornillos_y_tuercas/ISO4762_M3x12.step
Robot_6GDL_V11/03_STEP/Tornillos_y_tuercas/ISO4762_M3x14.step
Robot_6GDL_V11/03_STEP/Tornillos_y_tuercas/ISO4762_M3x16.step
Robot_6GDL_V11/03_STEP/Tornillos_y_tuercas/ISO4762_M3x25.step
Robot_6GDL_V11/03_STEP/Tornillos_y_tuercas/ISO4762_M4x12.step
Robot_6GDL_V11/03_STEP/Tornillos_y_tuercas/ISO4762_M4x16.step
Robot_6GDL_V11/03_STEP/Tornillos_y_tuercas/ISO4762_M4x25.step
Robot_6GDL_V6/00_Base/L0-01_Placa_inferior.SLDPRT
Robot_6GDL_V6/00_Base/L0-02_Pared_PosY_ventilacion.SLDPRT
Robot_6GDL_V6/00_Base/L0-03_Pared_NegY_puertos.SLDPRT
Robot_6GDL_V6/00_Base/L0-04_Pared_lateral_X.SLDPRT
Robot_6GDL_V6/00_Base/L0-05_Tapa_superior.SLDPRT
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
