Ulimanopano/Robot-6GDL/Robot_6GDL_V6/10_Motores/Fichas_y_STEP/GIM3505-36_sin_driver.pdf

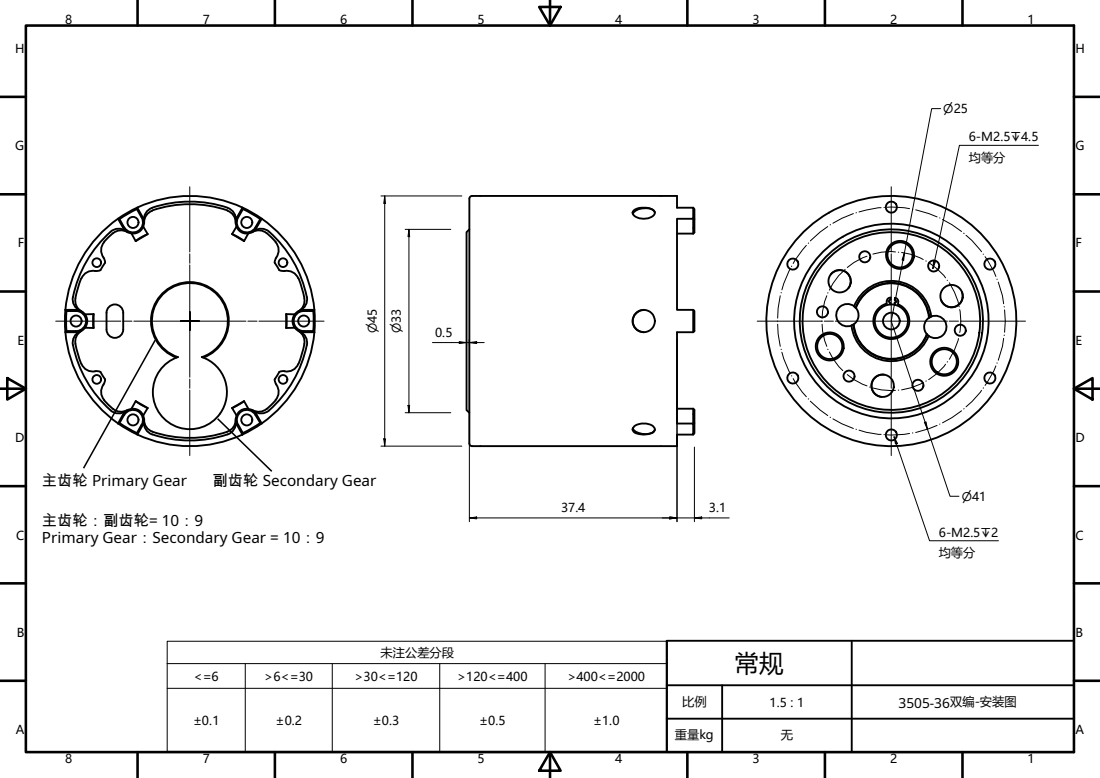
[picture p63: page 1]
3505-9双编-安装图; 主齿轮 Primary Gear; 副齿轮 Secondary Gear

主齿轮：副齿轮= 10：9
Primary Gear：Secondary Gear = 10：9

未注公差分段 | 常规

<=6 | >6<=30 | >30<=120 | >120<=400 | >400<=2000
±0.1 | ±0.2 | ±0.3 | ±0.5 | ±1.0 | 比例

重量kg | 无
