Ulimanopano/Robot-6GDL/Robot_6GDL_V6/10_Motores/Fichas_y_STEP/GIM3505-36_doble_encoder.pdf

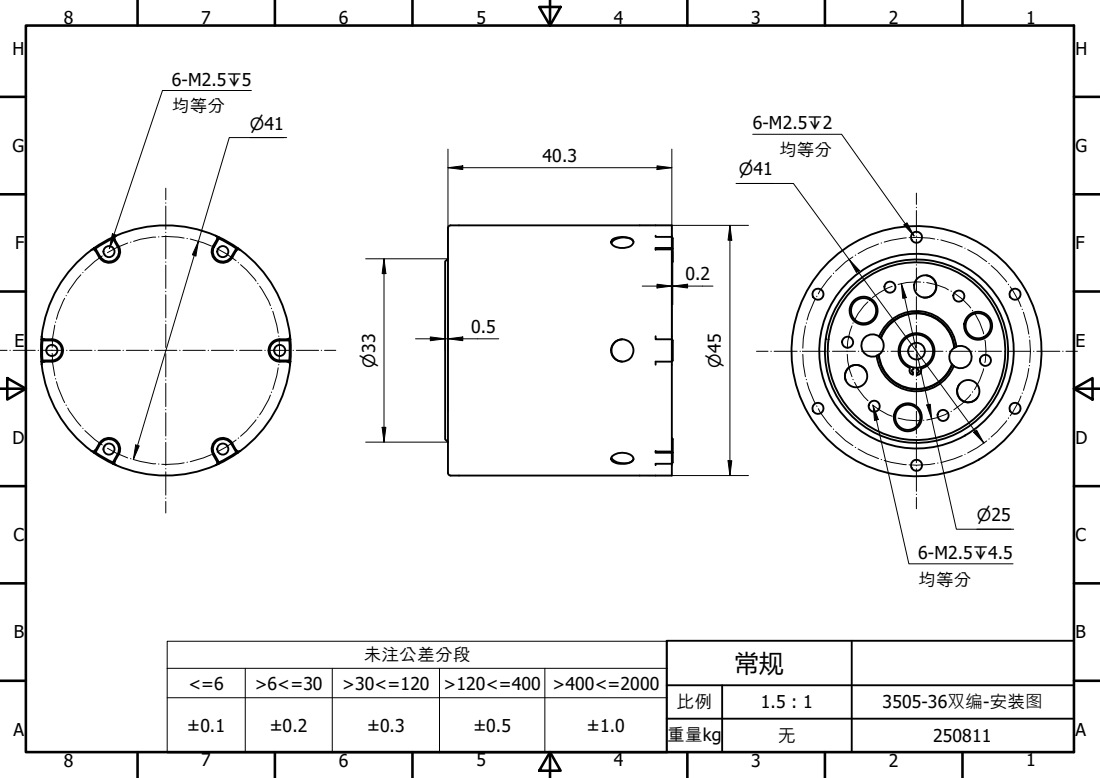
[picture p64: page 1]

未注公差分段 | 常规

比例 | 1.5 : 1 | 3505-36双编-安装图

重量kg | 无 | 250811
