Ulimanopano/Robot-6GDL/Robot_6GDL_V6/10_Motores/Fichas_y_STEP/GIM3510-64.pdf

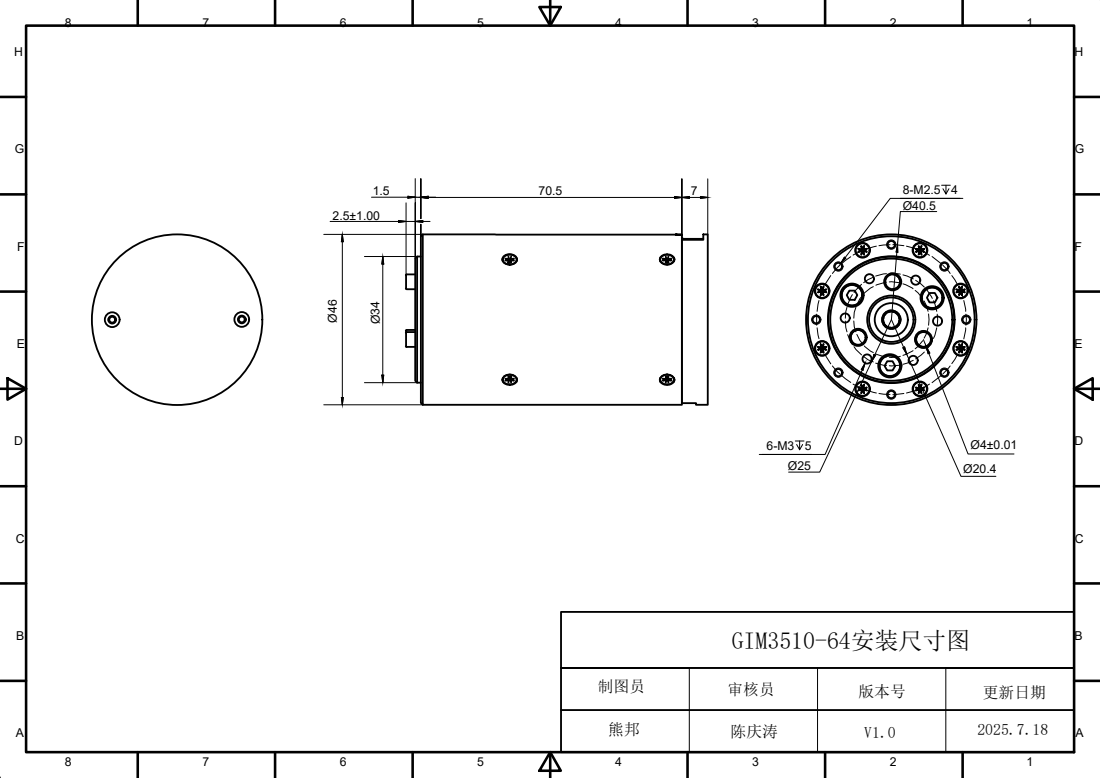
[picture p65: page 1]

Ø34 8-M2.5 4 6-M3 5 Ø4±0.01 Ø25 Ø20.4 Ø40.5 GIM3510-64安装尺寸图 制图员 审核员 版本号 V1.0 更新日期 熊邦 陈庆涛 2025.7.18
