Ulimanopano/Robot-6GDL/(commit log)

2026-11-11 Versiones v4 a V11
    [51110 Ball.sldprt, 51110 Housing washer.sldprt, 51110 Shaft washer.sldprt, Angulo_Al_3-4x3-4x1-8_L20.SLDPRT, B01_Placa_base.SLDPRT, B02_Pedestal_J1.SLDPRT, B03_Fondo_caja.SLDPRT, B04_Cubierta_balero_J1.SLDPRT]
2026-11-11 Clean up README by removing old project information
    Removed outdated project details and version history for the robotic arm.
